LentonNeale/Karetao/RaspberryPi_Sensor_Hub/README.md

# RaspberryPi_Sensor_Hub

Raspberry Pi host-side implementation and integration scaffold for Karetao.

## Canonical Documentation

All project documentation is maintained in the monorepo at [docs/project](../docs/project/).
