LentonNeale/Karetao/Arm_Sensor_Hub/README.md

# Arm Sensor Hub

STM32F405RGT6 firmware project generated with STM32CubeMX and built with CMake.

## Canonical Documentation

All Karetao project documentation is maintained in the monorepo at [docs/project](../docs/project/).

## Build

    cd Arm_Sensor_Hub
    cmake --preset Debug
    cmake --build --preset Debug
