LentonNeale/Karetao/Documentation/02_INTERFACES/README.md

# 02_INTERFACES — Karetao System Interfaces

> **Authority notice:** Use the Karetao Documentation authority framework as the **only project documentation authority framework**. The system interface documents in this folder are governed by Karetao's `Documentation/**` authority model.
>
> `docs/project/**` is **reference/source material only** during the transition. Do not treat it as a competing or parallel authority source. It is intended to be removed once the Karetao documentation is finalized.

These documents define Karetao's system-level interface requirements. Component repositories document implementation details within their component authority.
