LentonNeale/Karetao/icm-project/requester-profile.md

# Requester profile

How requests for Karetao are usually made, for any agent taking one. Edit freely; keep it short.

- **Who:** the project's maintainer, an electronics and computer engineer working on a personal
  robotic-arm project.
- **Aim:** keep the project on good engineering practice: requirements traceability, recorded
  decisions, and verification evidence before anything is called done.
- **Scope:** hobby level; one maintainer, attended operation, no PL/SIL claim. Goals,
  non-goals and who decides (Lenton Neale) are in
  `Documentation/01_SYSTEM/PROJECT_CHARTER.md`; numeric values need a basis (Measured,
  Datasheet, Derived or Provisional).
- **Authority:** `Documentation/**` is the system authority (start at `Documentation/00_INDEX.md`);
  a request that would change a requirement, interface or safety rule goes there first.
- **Current work:** GitHub issues on `LentonNeale/Karetao`, grouped by milestone (Stage 0 Foundation,
  then Stages 1 to 5 named after the charter goals) and ordered on the Karetao Engineering Project board.
  An issue is worked with the `/work-issue` skill; `/next-issue` says what is unblocked.
- **Output fixes:** for a fix that changes printed output, ask which exact text a test should check.
- **Style:** plain language; short questions, a few at a time.
