LentonNeale/Karetao/docs/project/SYSTEM_DECISIONS.md

> **Transitional status:** This legacy decision register remains decision provenance. Current system requirement wording is maintained in [Documentation/01_SYSTEM/SYSTEM_REQUIREMENTS.md](../../Documentation/01_SYSTEM/SYSTEM_REQUIREMENTS.md), and current architecture decisions are maintained in [Documentation/07_DECISIONS/ARCHITECTURE_DECISIONS.md](../../Documentation/07_DECISIONS/ARCHITECTURE_DECISIONS.md). SD identifiers, status, rationale and open issues remain preserved here during reconciliation. System-owned normative statements are reconciled into the requirements authority; component-only constraints and unresolved proposals are not promoted automatically.

# Karetao System Decisions Register

This file lists the current SD-01 through SD-26 system decisions and the unresolved system-level issues that remain attached to them.

**Source for SD-01 through SD-25:** [CTO Final Decisions](archive/Arm_Sensor_Hub/Documentation/Conversations/CTO_DECISION_FINAL.md), dated 2026-09-07.

> The source document approves the v1.0 firmware contract baseline for implementation. It does **not** certify the assembled robot as safe or authorize energized motion; release remains conditional on the listed safety, validation, and acceptance conditions.

> **Note on the "Possible solutions to investigate" column:** these are candidate directions for closing each open issue, offered for engineering evaluation — not decisions, and not a substitute for the machine risk assessment or safety-rated analysis required before energized-motion release.

## Decision table

| ID | Decision area | Status | Summary | Open issue / comment | Detailed explanation | Possible solutions to investigate |
|---|---|---|---|---|---|---|
| SD-01 | System timing | MODIFIED | 100 Hz remains the baseline for sensor/state publication and the initial control loop. **The EKF update rate is currently set to 500 Hz** and will be adjusted if required by downstream system constraints. SPI remains at a 5 MHz initial maximum, subject to validation. | The current six-axis physical sweep is approximately 46 ms. The 500 Hz EKF rate therefore requires the estimator to operate from timestamped/latest-value data rather than implying a 500 Hz complete six-axis sweep. End-to-end EKF data availability and latency remain integration items. | A full six-axis sweep at ~46 ms corresponds to a complete-cycle rate of roughly 22 Hz, more than an order of magnitude below the 500 Hz EKF rate. This is only workable if the EKF is designed as an asynchronous filter that predicts forward using its motion model between sensor updates and corrects opportunistically as individual, timestamped axis readings arrive — not as a filter expecting a fresh full-state vector every 2 ms. This decision does not yet specify the prediction/correction scheduling, how per-axis update staleness is bounded, or how SPI/CAN latency adds to the effective age of each measurement by the time it reaches the filter. | Implement the EKF as an asynchronous/multi-rate filter (predict-at-500-Hz, correct-per-axis-as-available) rather than a synchronous full-vector filter; instrument and log actual per-axis update latency on target hardware to replace the 46 ms estimate with measured data; run a covariance/sensitivity analysis to find the EKF rate where added computation stops improving estimate quality, and consider whether a lower, still-useful rate (e.g. 100–250 Hz) removes the mismatch entirely; prototype an out-of-sequence-measurement (OOSM) handling scheme if late-arriving axis data is common. |
| SD-02 | System-wide failure classification | MODIFIED | Four response levels: INFORMATIONAL, DEGRADED, FAULT, SAFETY_CRITICAL; PL/SIL determined by machine risk assessment. | The classification must be mapped to explicit motion-inhibit behaviour and ownership. A fault classification alone does not define who has final authority to prevent motion. | Naming four severity tiers answers "how bad is this fault," not "what happens to motion because of it." Each level needs a defined, deterministic action (allow motion, degrade capability, inhibit new commands, force stop) and an owner component responsible for enforcing that action even if other software layers disagree or lag. Without this mapping, two subsystems could reach different conclusions about whether motion is currently permitted. This ties directly to the open "motion-permission authority" question (system issue #5) and to the safety-boundary question in SD-25. | Build an explicit state/action matrix (severity level × required motion behaviour × owning component) as a standalone design artifact reviewed alongside the machine risk assessment; designate a single motion-permission authority (see SD-25) that all other components must query or defer to, rather than allowing distributed veto logic; model the classification-to-action mapping as a formal state machine and verify it has no reachable state where two components disagree on permission. |
| SD-03 | Raspberry Pi communication loss | APPROVED | 500 ms heartbeat timeout; reject motion, controlled stop if possible, then motor disable; never hold the last motion command. | "Controlled stop" and "motor disable" require measurable fault-to-safe-state timing. The exact stop-time requirement remains a system/safety validation item. | The decision fixes *when* loss is detected (500 ms) and *what* sequence follows (reject → controlled stop → disable), but not *how long* the physical arm is allowed to keep moving after detection before it must be at a safe state. That number depends on joint dynamics, payload, and the hazard zone defined by the machine risk assessment, and it is what turns "stop safely" into a testable requirement (see release condition #2). | Derive a maximum stop-time budget from the machine risk assessment's hazard/reach-zone analysis, then work backward to a required deceleration profile per joint; measure actual worst-case stop time on the assembled arm at maximum commissioned speed/payload and compare against the budget; consider whether 500 ms is still appropriate once stop-time is known, or whether detection time needs to shrink to leave enough margin for the mechanical stop. |
| SD-04 | Motor feedback/command timeout | APPROVED | Five times the commissioned feedback period; one miss degraded; three consecutive misses inhibit the motor and escalate to FAULT. | This primarily addresses feedback/timeout behaviour. **Command acknowledgement must be distinguished from feedback freshness.** A command that is transmitted but not acknowledged requires an explicit failure rule before motion is considered safe. | This rule protects against a motor going quiet (no feedback), but a motor can also silently fail to *receive or accept* a new command — feedback can keep flowing (stale, from the last accepted state) while the controller never executed the latest instruction. Feedback freshness alone cannot detect that case. A separate acknowledgement contract (does the controller confirm receipt/acceptance of each command, within what window, and what happens on a missed ack) is needed and feeds directly into SD-13 (state fields) and SD-14 (command interface). | Confirm whether the target MKS controller firmware supports an explicit command-accepted response (per SD-05); if it does, define an ack-timeout mirroring the feedback-timeout pattern (N missed acks → degraded → inhibit); if it does not natively ack, investigate an indirect check — comparing commanded setpoint against the next feedback sample to infer acceptance — as a fallback, and flag the added latency/ambiguity this introduces. |
| SD-05 | CAN network requirements | MODIFIED | 1 Mbps nominal v1 target, standard 11-bit IDs, <50–60% measured average load target; exact hardware and timing require validation. | Exact MKS controller model, firmware, command semantics, feedback semantics, acknowledgement behaviour, brake behaviour, and CAN physical configuration remain open until target-hardware evidence is recorded. | The bus-level parameters (bitrate, ID width, load ceiling) are fixed as targets, but nearly everything above the bus layer — what a specific MKS controller model actually accepts as commands, how it reports feedback, whether it acknowledges commands distinctly from reporting state, and how it engages/releases any holding brake — is vendor- and firmware-specific and has not yet been confirmed against real hardware. This is a direct prerequisite for closing SD-04 (acknowledgement), SD-06 (bus failure scope), and release condition #3. | Obtain and review the exact MKS controller datasheet/CAN protocol manual for the specific model and firmware revision in use; run a hardware bring-up/bench test logging real CAN traffic under representative motion to capture actual message IDs, payload semantics, and timing; test brake engage/release behaviour in isolation before integrating; measure actual bus load under worst-case simultaneous multi-joint motion against the 50–60% target. |
| SD-06 | CAN bus failure | APPROVED | Detect bus-off, inhibit commands, perform bounded recovery, escalate after repeated failure, and require explicit reactivation. | Confirm whether a CAN failure affecting one motor requires a joint-level stop or whole-system stop. Final scope follows the machine risk assessment. | The recovery *procedure* is defined, but its *blast radius* is not: if one motor drops off the bus, is it safe to keep other joints moving, or does the kinematic coupling (including the differential end effector in SD-26) mean any single-joint fault must halt the whole arm? This is a risk-assessment question, not a protocol question, because the answer depends on what hazardous motion or configuration becomes possible if only some joints stop. | Build a coupling/hazard matrix showing, for each joint (including the SD-26 differential pair), what motion becomes possible or unsafe if that joint alone stops while others continue; feed this matrix into the machine risk assessment to decide per-joint vs whole-system stop scope; consider a tiered response (isolated joint stop only when the risk assessment shows the remaining joints cannot create a hazard, whole-system stop otherwise) rather than a single fixed rule. |
| SD-07 | Joint/motor mapping | APPROVED | Versioned deterministic logical-joint, sensor-ID, motor/CAN-ID mapping including direction, zero offset, and transmission ratio. | The ordinary one-to-one mapping is insufficient for the differential end effector. SD-26 defines the separate motor-to-end-effector-DOF mapping decision. | This decision establishes the pattern for simple joints (one motor, one sensor, one logical joint) but explicitly does not attempt to cover the end effector, where two motors jointly produce two rotational degrees of freedom through a differential mechanism. That case needs its own transformation, which is why it is carved out into SD-26 rather than forced into this table's schema. | No independent action needed on this decision itself; track as complete pending SD-26 closure. When SD-26 is finalized, review whether the mapping schema (SD-07) needs a generalized "coupled joint group" extension so future multi-motor mechanisms don't each require a bespoke carve-out decision. |
| SD-08 | Motor/joint temporal alignment | APPROVED | Observation skew below 5 ms normally, target below 1 ms for dynamic joints; retain acquisition timestamps. | The approximately 46 ms six-axis sweep must be reconciled with estimator/control requirements. Timestamp compensation does not by itself establish that the resulting state update rate is acceptable. | Skew (how far apart in time two joints' readings were taken) and update *rate* (how often a fresh reading arrives at all) are different problems. Tagging every reading with an accurate timestamp lets the EKF correct for skew mathematically, but it cannot manufacture data that hasn't arrived yet — if the full sweep takes 46 ms, some joints' state is necessarily up to 46 ms old regardless of how well-timestamped it is. Whether that staleness, even when compensated, is acceptable for control at the target dynamics is still unresolved. | Investigate parallelizing or reordering the six-axis sweep (e.g. simultaneous multi-sensor sampling instead of sequential) to reduce the 46 ms figure directly; separately, run a control-loop sensitivity study to determine the maximum tolerable staleness per joint at target speeds, so "acceptable" becomes a number rather than a judgment call; evaluate whether faster-changing joints could be sampled preferentially/more often than slower ones within the sweep budget. |
| SD-09 | Measurement history ownership | APPROVED | Raspberry Pi/EKF owns measurement queues and estimator history; STM32 provides bounded latest-value caches and coherent records. | The 500 Hz EKF setting requires explicit definition of how latest-value records, asynchronous sensor updates, timestamp age, and interpolation/hold behaviour are handled. | Deciding *who* owns history (Pi/EKF) answers the architecture question but not the algorithm question: when the EKF ticks at 500 Hz and a given joint's cached value is, say, 30 ms old, does the filter hold that value, extrapolate it forward using the motion model, discard it as too stale, or flag it as degraded? That policy needs to be specified per-signal and validated, since it directly determines estimator accuracy. | Define and document an explicit per-signal staleness policy (hold / model-based extrapolate / reject-as-invalid) with a maximum-age threshold for each; prototype both a simple hold-last-value approach and a motion-model extrapolation approach in simulation, and compare estimate error against ground truth to choose between them; expose the chosen policy's threshold as a tunable configuration so it can be adjusted once real sweep-timing data is available. |
| SD-10 | Calibration ownership | APPROVED | Calibration computed on Pi/workstation; STM32 receives validated parameters through a controlled configuration path. | Calibration must cover the differential mechanism as well as individual motor/sensor offsets and ratios. | The current scope covers per-axis calibration (zero offsets, direction, ratio for simple joints). The differential end effector needs calibration of the *coupling* itself — e.g. how the two motor positions jointly map to the two DOF zero points — which is a different, coupled calibration problem that must be defined once SD-26's transformation is finalized. | Once SD-26's forward/inverse transformation is defined, design a coupled calibration procedure (e.g. jointly zeroing both end-effector motors against known DOF reference positions rather than calibrating each motor independently); extend the calibration parameter set and validated-configuration path (SD-10/SD-11) to include the differential mechanism's specific parameters (coupling ratios, joint zero references). |
| SD-11 | Calibration storage | APPROVED | Versioned, CRC-protected redundant STM32 flash records with power-loss protection and host-side source copy. | Calibration flash schema, endurance, power-loss behaviour, and parameter integrity remain release conditions. | The storage *architecture* (versioned, CRC-checked, redundant, mirrored to host) is decided, but the concrete schema layout, flash wear/endurance under expected write frequency, and behaviour under a power loss mid-write have not yet been tested on hardware. This is explicitly listed as release condition #6 and must pass before energized-motion release. | Define the concrete flash schema (field layout, version header, CRC placement) and review it against the target MCU's flash datasheet for write-cycle endurance at expected calibration-update frequency; run repeated power-loss-during-write tests on the actual STM32 target to confirm redundant records recover correctly; add a boot-time integrity check that falls back to the host-side source copy if both on-device records fail validation. |
| SD-12 | Authoritative angle representation | MODIFIED | Calibrated radians are authoritative at host/API; wire-schema change must be explicitly versioned rather than silently replacing millidegrees. | Migration requires a defined schema version, conversion rules, Pi decoder update, and verification evidence before the existing wire field changes meaning. | Changing what a wire field *means* (millidegrees → radians) without a version bump would silently break any consumer still assuming the old units — a subtle and dangerous failure mode for a motion system. This decision requires a concrete migration package (new schema version number, explicit conversion formula, updated Pi-side decoding, and test evidence that old and new consumers cannot misinterpret each other) before the field is actually changed. It is release condition #5. | Assign a concrete new schema/protocol version number now, even before the switch date, so it can be referenced by implementation work; write the conversion function and unit-test it against known reference angles; add a runtime schema-version check on the Pi decoder that refuses to interpret a frame as radians unless the version field confirms it, preventing silent misinterpretation; stage the rollout so STM32 and Pi are updated together rather than allowing a mismatched pair to run. |
| SD-13 | Required joint state | APPROVED | Stable joint identity, position, velocity where available, validity/status, acquisition timestamp, sync quality, and calibration version. | Add explicit commanded-vs-actual state validity and command acknowledgement status where required by the final motor interface. | The current state message tells a consumer what the joint's *measured* condition is, but not whether the *last commanded* value was actually accepted and achieved. Adding commanded-vs-actual fields and an acknowledgement-status flag closes the gap identified in SD-04 and gives downstream control/safety logic a way to detect "command sent but not honoured" without inferring it indirectly from feedback timing. | Extend the joint-state message schema with a commanded-setpoint field, an actual-vs-commanded delta or validity flag, and an acknowledgement-status enum, once SD-04/SD-05 settle what acknowledgement data is actually available from the controller; version this schema change the same way SD-12 handles the angle-representation change, so it doesn't silently redefine existing consumers' expectations. |
| SD-14 | Required command interface | MODIFIED | Commissioned position/velocity plus enable, disable, and controlled-stop operations; heartbeat, lifecycle, calibration, and safety gating required. | Define command acknowledgement, freshness, timeout, cancellation, and the distinction between application controlled-stop and independent emergency stop. | Several distinct behaviours are still bundled informally under "stop": an application-level controlled stop (software-initiated, can be smooth/coordinated) is not the same mechanism as the independent emergency stop required by SD-25 (hardware-level, safety-rated, must work even if the application software has failed). The command interface needs each of these — ack, freshness/timeout, cancellation, and the two stop types — defined as separate, unambiguous operations so that safety logic never has to guess which "stop" a given signal represents. | Define "controlled stop" and "emergency stop" as two distinct, separately-named operations in the command interface spec, each with its own trigger path, and document explicitly that emergency stop must remain reachable through the independent safety path (SD-25) even if the application-level command interface is unresponsive; add explicit ack/freshness/timeout/cancel semantics to each commissioned command type, reusing the acknowledgement contract developed for SD-04; validate with a fault-injection test that emergency stop still functions when the normal command channel is deliberately blocked. |
| SD-15 | Fixed SPI transaction | APPROVED | 512-byte frame, 490-byte maximum payload, SPI Mode 0, little-endian fields, CRC-32/ISO-HDLC, deterministic request/response ownership. | Protocol sizing is defined, but the 5 MHz operating point remains an empirical integration limit until live Pi/STM32 and physical-layer evidence is accepted. | The frame format, size limits, and integrity check are all fixed and implementable now, but the 5 MHz clock is a *target*, not a proven operating point — it depends on real cabling, connector quality, and electrical noise on the assembled hardware. It must be validated (signal integrity, error rate, timing margin) on the actual Pi/STM32 link before being frozen, per release condition #4. | Run signal-integrity testing (oscilloscope eye-diagram / rise-time checks on the physical SPI lines) at 5 MHz on the actual wiring harness and connectors used in the assembled robot; measure CRC failure rate over an extended soak test at 5 MHz vs at a reduced clock (e.g. 1–2 MHz) to establish margin; if 5 MHz proves marginal, evaluate shielded/twisted-pair wiring, shorter runs, or a lower validated clock as fallbacks. |
| SD-16 | GET_SNAPSHOT priority | APPROVED | Correlated GET_SNAPSHOT response takes priority; active DMA buffers remain immutable; replacement frames use replace-if-new policy. | Confirm replacement/drop semantics preserve the freshest state required by the 500 Hz EKF and do not create unacceptable state age. | "Replace-if-new" avoids stale data overwriting fresh data, but at 500 Hz the margin for error is small: if snapshot requests are frequent or DMA buffer immutability causes brief stalls, some replacement frames could be dropped rather than merely delayed, silently increasing the effective age of what the EKF consumes. This needs to be checked under realistic request/traffic patterns, not just verified as logically correct. | Instrument the actual replace/drop path to log every dropped or delayed replacement frame during integration testing, then compute resulting worst-case data age per joint under realistic (not just nominal) GET_SNAPSHOT request rates; if dropped-frame age exceeds the staleness threshold from SD-09, consider prioritizing replacement over snapshot correlation in specific cases, or increasing buffer depth so a snapshot request doesn't force a drop. |
| SD-17 | SPI host transaction strategy | APPROVED | DATA_READY interrupt for latency plus configurable polling, initially 1 ms, for recovery; Pi remains SPI clock master. | Current Pi baseline does not have a physical DATA_READY GPIO assigned. Until one is assigned and tested, the 1 ms polling path is the available host notification mechanism. | The design assumes a low-latency interrupt line (DATA_READY) as the primary notification path, with 1 ms polling only as a fallback for recovery scenarios. Because no GPIO pin has actually been assigned for this signal yet, the system is currently running on the fallback path as its *only* path — meaning real transaction latency today is bounded by the 1 ms poll interval rather than interrupt-driven response, which is a meaningfully different (slower, jitterier) timing profile than the design intends and is relevant to the SD-01/SD-08 timing questions. | Assign an available Pi GPIO pin to DATA_READY as a concrete near-term task, then wire and test interrupt-driven notification on the bench; until that's done, measure actual achieved latency/jitter under the 1 ms polling-only path so its real impact on SD-01's timing budget is known rather than assumed; once the interrupt path exists, A/B test interrupt-driven vs polling-only timing to confirm the expected latency improvement. |
| SD-18 | Timestamp accuracy | APPROVED | Target timestamp error ≤ ±1 ms relative to shared STM32/Pi time model; expose sync validity and age. | Validate whether ±1 ms is sufficient for the 500 Hz EKF and downstream control requirements. | A 500 Hz EKF has a ~2 ms nominal update period, so a ±1 ms timestamp error is a large fraction of that period — potentially half a cycle of uncertainty on when a measurement was actually taken. Whether this is tolerable depends on how sensitive the estimator and controller are to timing error at the target dynamics; it has not yet been validated against the actual 500 Hz operating condition, only specified as a target. | Run a simulation or bench test injecting known timestamp errors up to ±1 ms into the EKF and measure resulting state-estimate error at the target 500 Hz rate and expected joint speeds; if error is unacceptable, investigate tightening the time-sync mechanism (see SD-19) or hardware timestamping closer to the sensor to reduce jitter, rather than relaxing the EKF rate. |
| SD-19 | TIME_SYNC frequency | APPROVED | 1 Hz nominal, configurable to 10 Hz; synchronization invalid after five seconds without an accepted update. | Validate synchronization stability and timestamp error under the 500 Hz estimator operating condition. | Sync frequency and the 5-second invalidation window were set independently of the 500 Hz EKF decision. It remains to be confirmed that clock drift between syncs stays within the ±1 ms budget (SD-18) for the full duration between updates, especially at the faster estimator rate where accumulated drift has more opportunities to matter before the next correction. | Measure the actual free-running clock drift rate of the STM32 oscillator between syncs on real hardware, and calculate whether drift stays under ±1 ms across a full 1 Hz sync interval (and worst-case up to the 5-second invalidation window); if drift exceeds budget, evaluate raising TIME_SYNC frequency to the already-supported 10 Hz configuration rather than changing the protocol. |
| SD-20 | Loss of time synchronization | MODIFIED | Continue acquisition/diagnostics but inhibit time-dependent motion until synchronization returns. | Define precisely which downstream operations are "time-dependent motion" and ensure the motion-permission layer enforces this consistently. | The rule correctly separates "keep gathering data" from "don't move," but "time-dependent motion" is not yet an enumerated, unambiguous category. Does it mean all motion (since the EKF that informs control is itself time-dependent), or only specific trajectory-timing-sensitive operations? Without a precise definition, different components could apply the rule inconsistently, undermining the intended safety effect. | Produce an explicit enumerated list of which operations count as "time-dependent motion" (likely: all closed-loop motion, since the EKF feeding the controller is itself time-dependent) and document it alongside SD-02's classification matrix; implement the check as a single shared gate in the motion-permission authority (see SD-02/SD-25) rather than letting each component independently interpret "time-dependent," and add an integration test that forces a sync loss and confirms motion is actually inhibited end-to-end. |
| SD-21 | Time offset validation | APPROVED | Wide initial offset range, then narrower runtime validation initially ±1 s; reject implausible updates without silent slew. | Verify that the initial and runtime bounds are appropriate for commissioning and reset behaviour. | The two-tier bound (loose at startup, tight at runtime) and the "reject rather than silently slew" rule are sound in principle, but the actual numeric bounds are provisional. They need to be checked against real commissioning scenarios (e.g. how far off can the clock plausibly be at first boot) and reset scenarios, to confirm they neither reject legitimate corrections nor accept implausible ones. | Survey realistic worst-case initial clock offset at cold boot (e.g. STM32 with no RTC vs one with battery-backed RTC) to confirm the wide initial range actually covers it; during commissioning and reset testing, log any legitimate TIME_SYNC updates that get rejected by the ±1 s runtime bound to check for false rejections; tune the bounds based on this evidence rather than leaving them at their initial provisional values. |
| SD-22 | Time behaviour after reset | APPROVED | Clear sync validity and volatile offset; timestamps remain unsynchronized until a new accepted TIME_SYNC. | Confirm that all consumers, especially the 500 Hz EKF, reject or correctly classify unsynchronized data after reset. | Clearing sync state on reset is only effective if every downstream consumer actually checks and respects the sync-validity flag before trusting a timestamp. The EKF is the most exposed consumer, given how timing-sensitive it is at 500 Hz — if it were to consume unsynchronized, arbitrarily-offset timestamps as if they were valid, it could produce a badly wrong state estimate immediately after a reset. This needs to be verified in the actual estimator implementation, not just assumed from the protocol design. | Add an explicit unit/integration test that forces a reset, then confirms the EKF (and every other timestamp consumer) either ignores incoming data or flags it degraded until a fresh TIME_SYNC is accepted; audit the EKF implementation specifically for any code path that could use a timestamp without first checking its validity flag; consider having the STM32 refuse to publish state data at all (rather than publishing with a validity flag) during the unsynchronized window, removing reliance on every consumer checking correctly. |
| SD-23 | Transient vs persistent fault recovery | APPROVED | Bounded service-specific retries; persistent/repeated/freshness failures enter ERROR and recover to INACTIVE. | Define system-level escalation when a subsystem is recovering but motion cannot be considered safe. Recovery must not race with motion permission. | Each service's retry/recovery logic is defined locally, but there is no stated rule for the *system-level* moment in between — while a subsystem is mid-recovery, is motion automatically inhibited, or could a different subsystem (unaware of the in-progress recovery) grant motion permission based on stale or partial information? This is a race-condition risk between per-service recovery state machines and the motion-permission logic referenced in SD-02. | Model recovery-in-progress as an explicit state visible to the motion-permission authority (SD-02), so permission logic can query "is anything currently recovering" rather than relying on each service to separately signal readiness; design and run a race-condition test that deliberately triggers a recovery and a motion request at the same time to confirm permission is correctly withheld until recovery fully completes; consider a system-wide "not ready" latch that only clears once all recovering services report healthy. |
| SD-24 | System restart and recovery | APPROVED | Return to INACTIVE; explicit dependency-ordered reactivation required; never automatically resume motor motion after recovery. | Establish the complete dependency order across STM32, Pi, ROS 2, EKF, ros2_control, MoveIt 2, and safety gating before physical motion release. | "Dependency-ordered reactivation" is the principle, but the actual ordered sequence — which subsystem must be confirmed healthy before the next is allowed to activate, across firmware, middleware, estimator, control, planning, and safety layers — has not yet been written down as a concrete startup/recovery sequence. This is needed before any physical motion release, since an incorrectly-ordered restart could bring motion capability online before, e.g., the safety system or EKF are actually ready. | Draft an explicit startup/recovery dependency graph naming each subsystem (STM32 firmware, Pi/ROS 2 bring-up, EKF initialization and sync acquisition, ros2_control, MoveIt 2, independent safety system) and the specific readiness condition each must satisfy before the next may proceed; implement this as a supervised, checked sequence (not just documentation) so activation cannot skip ahead if a dependency check fails; test the sequence under partial-failure scenarios (e.g. EKF slow to sync) to confirm it holds rather than proceeding anyway. |
| SD-25 | Independent safety mechanisms | MODIFIED | Independent E-stop, motor-disable/power-removal path, watchdog, stop/brake behaviour, fault indication, reset behaviour, and applicable safety-rated architecture are release gates. | The boundary and interface between Karetao application controls and the independent safety system must be explicitly defined by the machine risk assessment and safety architecture. | This decision commits to having an independent (i.e. not solely software-dependent) safety layer, but does not yet define exactly where the line sits between "the application software's controlled stop" and "the independent safety system's emergency stop" — what triggers each, whether they can interact, and what happens if the application layer disagrees with the safety layer. That boundary is properly a machine-risk-assessment and safety-architecture output, referenced as the unresolved dependency here and in SD-14. | Commission or complete the machine risk assessment as the primary input for this boundary, since it determines the required PL/SIL and therefore what must be independent of the application software; draft a safety architecture diagram explicitly showing which functions live in the independent safety path vs the application path, and where they physically/electrically interface (e.g. does the safety system have authority to cut power regardless of application state); validate with a fault-injection test that the independent path still functions with the application software deliberately disabled or hung. |
| SD-26 | Differential end-effector motor/DOF mapping | PROPOSED | The two end-effector motors drive two end-effector rotational DOFs through a differential mechanism. The mapping must be represented explicitly rather than as two independent one-to-one joints. | Define the forward/inverse transformation, motor signs, gear ratios, zero offsets, joint limits, singular/invalid configurations, and representation in ros2_control and MoveIt 2. This remains open until the mechanical model and mapping are verified. | Unlike the simple joints covered by SD-07, the two end-effector motors do not each correspond one-to-one with a single DOF; their combined positions determine both output DOFs through the differential mechanism. Closing this decision requires: the math (forward and inverse kinematics of the coupling), the physical parameters (motor sign conventions, gear ratios, zero references), the safety-relevant edges (joint limits and any singular or invalid motor-position combinations that would produce an undefined or unsafe output), and how all of that is represented as a proper model inside ros2_control and MoveIt 2 rather than being approximated as two independent joints. This is a prerequisite for SD-07's joint model being considered complete and is still PROPOSED, not approved. | Derive the differential mechanism's forward/inverse kinematic equations from its physical/CAD design and verify them against direct measurement on the assembled end effector; identify and document any singular or invalid motor-position combinations analytically, then add software-level limit checks that reject commands leading into them; implement the mapping as a custom ros2_control transmission (or MoveIt 2 joint group with a mimic/coupling constraint) rather than exposing the two motors as independent joints, and validate with hardware-in-the-loop testing across the full range of motion including near-limit and near-singular configurations. |

## Decision status

- **APPROVED:** 18
- **MODIFIED:** 7
- **PROPOSED:** 1
- **Total:** 26

## System-level issues still requiring closure

1. **EKF timing:** EKF is currently set to **500 Hz**; downstream constraints may require adjustment. This does not mean the complete six-axis sensor scan currently operates at 500 Hz.
2. **Sensor failure response:** The requirement that sensor-data failure stops motion needs an explicit rule covering invalid, missing, stale, and failed sensors.
3. **Motor command acknowledgement:** Command acknowledgement must be separately defined from motor feedback and communication heartbeat.
4. **Fault-to-safe-state timing:** "Stop immediately" must become a measurable timing requirement.
5. **Motion-permission authority:** Define which system component has final authority to permit or inhibit motion.
6. **Differential end effector:** The two-motor/two-DOF mechanical transformation must be formally defined before the joint model is frozen.
7. **Motor-controller semantics:** Exact MKS controller behaviour remains an integration dependency.
8. **Safety boundary:** Define the interface between application-level safety controls and the independent safety function.
9. **MoveIt 2 / ros2_control model:** The authoritative mechanical/joint model must include the differential end effector and its limits.
10. **Sensor update architecture:** Determine how a 500 Hz EKF consumes asynchronously updated sensor records and what maximum data age is acceptable.

These issues are intentionally recorded as open requirements rather than being assigned assumptions in this document.

## Important release conditions

The source approval identifies the following conditions before energized-motion release:

1. Complete and approve the machine risk assessment, including required safety functions and PL/SIL target.
2. Validate the independent E-stop and motor-disable path, measured stopping time, watchdog behaviour, and actuator brake/power behaviour on the assembled system.
3. Verify the exact MKS controller, CAN physical topology, APB1-derived bit timing, worst-case bus load, recovery behaviour, and termination before freezing CAN production configuration.
4. Validate the 5 MHz SPI limit, 1 ms polling fallback, GPIO notification, DMA timing, signal integrity, and host-stall recovery with the Raspberry Pi.
5. Version the radians representation before changing the current processed-millidegree wire field.
6. Complete calibration flash endurance, power-loss, schema, and parameter-integrity tests.
7. Treat failure of these conditions as a release blocker for energized motion.

## Authority and traceability

This register is a concise index of the current system decisions. The archived CTO decision document remains the detailed source for SD-01 through SD-25 rationale, value/policy, and approval conditions.

SD-26 is a project-level proposed decision added after review of the current Karetao system definition and is not part of the 2026-09-07 CTO approval.

If a decision is changed, update this register and the authoritative decision record together. Do not use this summary to override a newer approved system decision.
