LentonNeale/Karetao/Arm_Sensor_Hub/Documentation/CONTRACT_STATUS.md

# Contract Status Matrix

This matrix tracks project-level contracts across three independent dimensions:

- **Document status:** whether the contract document exists and is maintained.
- **Implementation status:** how much of the documented behavior exists in firmware.
- **Freeze status:** whether the contract is approved for implementation or still has integration gates.

| Contract | Owner | Boundary | Document status | Implementation status | Freeze status | Dependencies | Next action |
| --- | --- | --- | --- | --- | --- | --- | --- |
| [Contract v1.0 freeze](CONTRACT_V1_FREEZE.md) | System architecture | Cross-contract decisions | Exists | Reconciliation baseline | Approved baseline; integration/release gates remain | All contracts, Pi review | Complete named CAN, SPI, motor, and safety gates |
| [Lifecycle](LIFECYCLE_CONTRACT.md) | Application/system | App services and system sequencing | Exists | Configuration reaches INACTIVE after kernel initialization; one-shot dependency activation runs from default task context | Approved baseline | FreeRTOS task context, configuration/calibration/time/safety prerequisites | Implement prerequisite validation and explicit post-recovery activation request |
| [SPI host](SPI_CONTRACT.md) | System/Pi + STM32 | Raspberry Pi <-> SPI3 wire protocol | Exists | Fixed-frame validation, CRC, request/response priority, DATA_READY state, boot/status sequencing, and snapshot frame serialization are host-tested; DMA arm/complete/abort/re-arm loop executed on target hardware 2026-09-17 with no live SPI host attached; NSS behavior and signal integrity unmeasured | Approved baseline; maximum SPI clock gate remains | Payload schema, SPI service | Repeat the DMA run with a live Raspberry Pi host clocking real transactions, then validate the 5 MHz initial maximum with DMA, GPIO, and signal-integrity tests |
| [CAN service](CAN_SERVICE_CONTRACT.md) | CanService | App <-> CAN/MKS transport | Exists | Task-owned bounded priority TX queue, bounded retry policy, latest-value cache, and task-context bus-off stop/start path implemented; policy primitives host-tested and firmware build-covered, hardware behavior unvalidated | Approved baseline; CAN integration gate remains | Lifecycle, MKS codec, HAL CAN | Validate exact controller, transceiver/topology/termination, candidate timing, measured load, retry timing, and recovery behavior |
| [SPI payload](SPI_PAYLOAD_SCHEMA.md) | Application data model | Application records <-> SPI payload | Exists | Fixed offsets, snapshot sizing, and encoder output for sensor/motor caches are host-tested | Approved baseline | SPI host contract, timestamps | Extend coverage as more motor/sensor fields become live and retain target validation evidence |
| [Snapshot coherency](SNAPSHOT_COHERENCY_CONTRACT.md) | Sensor/CAN/SPI | Producers <-> SPI-owned snapshot | Exists | Two-buffer ownership, replacement diagnostics, and latest-cache snapshot serialization are host-tested | Approved baseline | Multi-sensor, SPI service | Expand producer coverage beyond the current commissioned sensor/motor set |
| [SPI service](SPI_SERVICE_CONTRACT.md) | SpiSlaveService | App payload <-> SPI3 DMA | Exists | Host-tested request/response, staged boot status, lifecycle-state NACKs, snapshot serialization, armed-then-assert DATA_READY, 1 ms poll recovery, and the SPI3 DMA arm/complete/error/stall process loop (stubbed HAL); firmware target compiles and, as of 2026-09-17, ran on a physical STM32F405 for ~23 s with the arm/stall/abort/re-arm cycle observed via debugger (234 cycles, zero drops, no live SPI host attached; DATA_READY pin level and NSS/DMA timing not independently measured) | Approved baseline; maximum SPI clock gate remains; DATA_READY wording revised to armed-then-assert 2026-09-17 | Payload, coherency, HAL DMA | Repeat the run with a live Raspberry Pi host and complete documented Pi/DMA/GPIO/signal-integrity clock acceptance testing |
| [I2C manager](I2C_MANAGER_CONTRACT.md) | I2CManager | App <-> I2C1 HAL | Exists | Public API/lifecycle exist; async completion and event delivery are deferred to task context; mux-plus-sensor composite write/read path is implemented for AS5600 access | Approved baseline | Lifecycle, mux | Expand composite-access coverage and define broader arbitration/recovery behavior |
| [Multi-sensor](MULTI_SENSOR_CONTRACT.md) | SensorTask/TCA9548A | Six AS5600 channels <-> sensor model | Exists | Six stable latest-value records; all six channels swept per 20 ms pass since 2026-09-15, ahead of the contract, with scan period, settle time, per-channel timeout, and healthy-channel threshold not frozen; host-tested on the communication-failure path; axis-to-mux-channel binding is configurable as of 2026-09-17 via `SensorTask_ConfigureMuxChannels()`, host-tested for validation and non-identity binding, with activation gated on a valid map; target run 2026-09-17 confirmed all six commissioned axes (SD2-SD7) reading valid magnet samples with zero communication or magnet errors, via `tools/check-sensors.sh`; an earlier SD2 wiring fault and magnet-placement issues were resolved on the bench; measured full six-axis sweep time (~46 ms) exceeds the 20 ms scan period the contract has not yet frozen | Approved baseline; scan parameters unfrozen | I2C, snapshot, mapping, calibration | Freeze scan period, per-channel timeout, and settle time in the contract against the measured ~46 ms sweep time |
| [Timestamp sync](TIMESTAMP_SYNC_CONTRACT.md) | System/SPI | STM32 monotonic time <-> Pi time | Exists | 64-bit TIM2 service, runtime sync state, and live SPI TIME_SYNC task-context acceptance are host-tested; target-hardware validation remains | Approved baseline | SPI transport, TIM2 | Validate end-to-end Pi-driven TIME_SYNC behavior on target hardware and retain build evidence |
| [Calibration records](CALIBRATION_CONTRACT.md) | Application configuration | Offline calibration -> validated STM32 parameters | Exists | Versioned record validation and generation selection host-tested; persistence absent | Approved baseline | Shared CRC helper, mapping, lifecycle | Define canonical CRC serialization and flash persistence/power-loss handling |
| [Joint mapping](JOINT_MAPPING_CONTRACT.md) | Application configuration | Logical joints -> AS5600 and CAN motor identities | Exists | Versioned one-to-one mapping validation host-tested; startup blocks dependent activation when invalid | Approved baseline | Calibration, SensorTask, future MotorService | Commission complete physical mapping and bind it to persisted configuration |
| [Error handling](ERROR_HANDLING_STRATEGY.md) | System | Service faults <-> lifecycle/health/host | Exists | Local statuses/counters exist | Approved baseline | Lifecycle, Health Monitor | Implement response-level events and bounded recovery escalation |
| [Health monitor](HEALTH_MONITOR_CONTRACT.md) | HealthMonitor | Service diagnostics -> system health | Exists | Read-only aggregate snapshot baseline implemented for lifecycle states, sync validity, and key counters; no host publication or fault-ack flow yet | Approved baseline | All services, error strategy | Expand snapshot thresholds, host reporting cadence, and fault acknowledgement behavior |
| [Build/configuration](BUILD_CONTRACT.md) | Buildsystem | Developer environment -> firmware | Exists | HostTests configure/build/test pass; Debug and Release compile and link with arm-none-eabi-gcc 13.2.1 on a developer machine; `arm-ci` now includes a firmware-build job whose first run result is not yet recorded; on 2026-09-17 the Debug build was flashed to a physical STM32F405 via ST-LINK/V2.1 and booted, with all four services (I2C, CAN, SPI, Sensor) reaching `LIFECYCLE_STATE_ACTIVE` with zero activation failures over a ~23 s debugger-sampled run | Approved baseline | CMake, CubeMX, toolchain | Record the first CI firmware-build result; retain size/checksum artifacts and this boot run as target-build evidence |
| [Motor service](MOTOR_SERVICE_CONTRACT.md) | Future MotorService | Joint API -> CanService | Exists | No separate MotorService exists | Integration gate: exact controller behavior and commissioned commands | Define only when needed | Verify exact controller behavior before freezing command semantics |

## Review Rules

- A contract must not claim an implementation exists when the corresponding service is still a scaffold.
- Remaining gates must be explicitly marked: CAN bitrate and physical/retry/TX policy; maximum SPI clock acceptance; exact motor-controller behavior; and independent safety validation/machine risk assessment. The 1 Mbps CAN target and 5 MHz initial SPI maximum are configuration baselines, not approvals for production use. Approved v1.0 values must not be described as open.
- Implementation changes that alter a contract require updating the contract and this matrix in the same change.
