LentonNeale/Karetao/Arm_Sensor_Hub/Documentation/SPI_SERVICE_CONTRACT.md

# Deprecated local copy

The canonical monorepo SPI service contract now lives at [`/docs/interfaces/spi-service-contract.md`](../../docs/interfaces/spi-service-contract.md).

Keep this stub so older local links continue to resolve from the ARM subtree.
