LentonNeale/Karetao/icm-project/workspaces/portal-retirement-2026-10-15/body-B62.md

Origin: backlog story B62 (WP9, "S9.11 Pi packaging and small defects: pyproject, shared ACK parser and sequencer, resource cleanup, stable spidev path, adapter tests")

## Context

The Pi package has no `pyproject`, the ACK parser and sequencer are duplicated, resources are not released on error, the spidev device path is not stable across bus renumbering, and the adapters lack tests (findings HOST-21 to HOST-25).

## Scope

Packaging and small defects in `RaspberryPi_Sensor_Hub/src/spi` and `tools`. The shared sequencer is the process-wide Sequencer built by the Pi exchange-session issue; this issue points at it and does not build a second one.

## Acceptance Criteria

- [ ] A `pyproject` makes the Pi package installable and the tests runnable from it
- [ ] There is one ACK parser and one sequencer, shared by the library and the tools
- [ ] SPI and GPIO resources are released on error paths, covered by tests
- [ ] The spidev path is stable across bus renumbering (see the linux-spidev bus-number note)
- [ ] The SPI adapters have unit tests
- [ ] Each finding is resolved as its report proposes, or a ruling by Lenton Neale records why not
- [ ] HostTests, the Debug build and the Pi tests pass; `doc_check` is clean
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
