LentonNeale/Karetao/Documentation/03_COMPONENTS/README.md

# 03_COMPONENTS — Karetao System Component Definitions

> **Authority notice:** Use the Karetao Documentation authority framework as the **only project documentation authority framework**. Karetao owns the system-level definition of components; component repositories own implementation documentation within their scope.
>
> `docs/project/**` is **reference/source material only** during the transition. It is not current authority and is intended to be removed once the Karetao documentation is finalized.

Do not infer authority from directory location alone. Use `DOCUMENTATION_AUTHORITY_MODEL.md` and `COMPONENT_DOCUMENTATION_MODEL.md` for the applicable authority boundary.
