LentonNeale/Karetao/workspace/setup/templates/icm-project/github.md

# Tracker conventions

Identifiers are in `github.env`. The rules below are pointers to the project's own contract where one exists.

## Titles

## Labels (approved)

## Board fields

| Field | Options |
|---|---|

## Milestones

## Register (optional)

<!-- Path, and which columns issue-clerk may change. -->

## Branching / push policy
