LentonNeale/Karetao/workspace/setup/templates/icm-project/requester-profile.md

# Requester profile

Read by `client-liaison` at the start of every conversation. It records how this project's requester usually phrases requests: what they reliably provide, what they often leave out or keep vague, and what their shorthand means. It is built from evidence (for example `workspace/tests/liaison/extract_prompts.py` plus an analysis) and updated as habits change.

## Reliably provided (don't re-ask)

## Often missing: ask proactively

| Gap | When it shows up | Question to ask |
|---|---|---|

## Often vague: ask for the concrete form

| Vague form | Ask for |
|---|---|

## Unstated expectations: confirm up front

| Expectation | Question to ask |
|---|---|

## Phrasing guide

| Phrase or spelling | Means |
|---|---|
