LentonNeale/Karetao/workspace/setup/templates/icm-project/build.md

# Build and test commands

| Component | Directory | Command | Notes |
|---|---|---|---|
