LentonNeale/Karetao/workspace/setup/templates/icm-project/PROJECT.md

# Project

<!-- One paragraph: what the project is. -->

## Components

| Path | What it is | Notes |
|---|---|---|

## Shared interfaces (keep in lockstep)

| Interface | Implementations | Contract |
|---|---|---|
