LentonNeale/Karetao/icm-project/workspaces/implement-step.overlay/stages/02-change/CONTEXT.md

## Inputs

| References | `../../shared/references.md` | Only the rows for the code areas this step touches, then only the note and section each row names | Datasheet, protocol and API facts the change must match; never values from memory |
