LentonNeale/Karetao/Documentation/05_VERIFICATION/README.md

# 05_VERIFICATION — Karetao System Verification

> **Authority notice:** Use the Karetao Documentation authority framework as the **only project documentation authority framework** for Karetao system documentation and governance.
>
> `docs/project/**` is **reference/source material only** during the transition. It may be consulted for provenance and evidence review, but it is not current authority and is intended to be removed once the Karetao documentation is finalized.

`SYSTEM_VERIFICATION_MATRIX.md` is the authoritative location for Karetao system-level verification status. Component evidence does not by itself establish system verification.
