LentonNeale/Karetao/Documentation/05_VERIFICATION/TIME_SYNC_CHARACTERISATION_EVIDENCE.md

# TIME_SYNC Implementation and Contract Audit

> **As-built.** This document describes the current TIME_SYNC implementation (STM32-held offset, one-way TIME_SYNC). That design is superseded by [Issue #12](../07_DECISIONS/ISSUE_12_CLOCK_SYNCHRONIZATION_DECISIONS.md) (2026-09-24) and will change when Issue #12 is implemented. Do not treat the mechanism described here as the target design.

**Status:** Integration audit in progress — five implementation gaps identified  
**Scope:** Verification of TIME_SYNC and time-offset contract clauses against STM32 and Raspberry Pi implementation  
**Audit date:** 2026-09-21

---

## Summary

This audit maps contract requirements from TIME_SYSTEM_INTERFACE.md, SPI_SYSTEM_INTERFACE.md (§11–12), and SPI_PAYLOAD_SCHEMA.md against current implementation in:

- **STM32 firmware:** `time_service.c`, `spi_protocol.c`, `spi_slave_service.c`, `sensor_task.c`, `main.c`
- **Raspberry Pi host:** `RaspberryPi_Sensor_Hub/src/spi/spi_protocol.py`, `spi_device.py`

**Result:** 20 contract clauses audited. 15 IMPLEMENTED, 4 GAPS, 1 CONFLICT (detailed in § Audit below).

Five known implementation gaps are documented without proposed fixes:

1. `frame_time_us` populated with raw local TIM2 time, not hub time
2. `measurement_timestamp_us` exported as raw local time without offset application
3. DIAGNOSTIC message (0x03) with `time_sync_valid` field not implemented
4. Accepted `time_offset_us` not carried in any v1 SPI payload
5. Raspberry Pi has no TIME_SYNC encoder/sender implementation

---

## § Audit

| # | Contract Clause | Status | File:Function:Line | Evidence |
|---|---|---|---|---|
| **Time Model** |
| 1 | STM32 local time is monotonic, never reset during synchronization | IMPLEMENTED | `time_service.c:54–71` (TimeService_StateNowUs) | Monotonic counter wrap handling preserves local clock across sync operations. No reset in TimeService_SyncStateAccept (line 222–256). |
| 2 | Offset formula: `hub_time_us = local_time_us + time_offset_us` | IMPLEMENTED | `time_service.c:222–256` | TimeService_SyncStateAccept calculates offset as `pi_time_us - t_stm32` (contract line 54). Offset storage at line 249. |
| **Measurement Timestamps** |
| 3 | `measurement_timestamp_us` exported in synchronized Pi time domain | **GAP-2** | `sensor_task.c:165–173` | Raw `sample.timestamp_us` passed to SensorLatestValue_SetValid without offset application. Time sync validity passed (line 172) but offset not applied to measurement timestamp. |
| 4 | `frame_time_us` identifies frame assembly time (SPI frame header) | **GAP-1** | `spi_protocol.c:33` | Frame time set as `TimeService_NowUs()` — raw local TIM2 counter, not hub time. Should be `local_time + offset`. |
| **TIME_SYNC Transaction** |
| 5 | TIME_SYNC payload schema (schema_version, reserved, flags, pi_time_us, sync_seq) | IMPLEMENTED | `spi_protocol.c:100–123` (SpiProtocol_ParseTimeSyncRequest) | Payload parsing extracts all required fields from offset 0–15 in payload. SPI_PAYLOAD_SCHEMA.md structure matches. |
| 6 | STM32 captures local monotonic time `t_stm32` when processing | IMPLEMENTED | `spi_slave_service.c:354` | TimeService_AcceptSync called with TimeService_NowUs(), capturing local time in task context. |
| 7 | Offset calculation: `time_offset_us = pi_time_us - t_stm32` | IMPLEMENTED | `time_service.c:133–172` (TimeService_CalculateOffset) | Signed offset calculation at line 144–169. Contract formula matches. |
| 8 | Offset and validity stored atomically | IMPLEMENTED | `time_service.c:249–254` | TimeService_SyncStateAccept atomically updates offset, sequence, timestamp, validity, quality in one function. No interleaving risk. |
| **Synchronization Validity** |
| 9 | Validity timeout: 5 seconds | IMPLEMENTED | `time_service.h` (TIME_SERVICE_DEFAULT_VALIDITY_TIMEOUT_US) | Default set to 5,000,000 µs (5 seconds). TimeService_SyncStateRefresh checks elapsed time at line 268. |
| 10 | time_sync_valid transitions to false after timeout | IMPLEMENTED | `time_service.c:261–272` (TimeService_SyncStateRefresh) | Line 270: `state->valid = false` when `(local_time_us - state->last_sync_local_time_us) >= config.validity_timeout_us`. |
| 11 | Quality reported as SYNCHRONIZED or UNSYNCHRONIZED | IMPLEMENTED | `time_service.c:219, 254, 271` | Line 219 (reset): UNSYNCHRONIZED. Line 254 (after accept): SYNCHRONIZED. Line 271 (after timeout): UNSYNCHRONIZED. |
| **Rejection Criteria** |
| 12 | Initial offset acceptance: default ±24 hours | IMPLEMENTED | `time_service.h` (TIME_SERVICE_DEFAULT_INITIAL_OFFSET_LIMIT_US) | Default 24-hour bound checked in TimeService_SyncStateAccept at line 239–240. |
| 13 | Runtime step bound: ±1 second | IMPLEMENTED | `time_service.h` (TIME_SERVICE_DEFAULT_RUNTIME_OFFSET_STEP_LIMIT_US) | Default 1-second step limit. Checked at line 241–244 (TimeService_OffsetStepWithinLimit). |
| 14 | Strictly newer sequence number required | IMPLEMENTED | `time_service.c:234–237` (TimeService_IsSequenceNewer) | Line 179: wrap-tolerant comparison. Rejected if not strictly newer. |
| 15 | Rejected updates retain previous state and are reported | IMPLEMENTED | `spi_slave_service.c:351–362` | Rejection returns TIME_SERVICE_SYNC_REJECTED_* codes. NACK sent with detail code at line 356–358. |
| **Motion Safety** |
| 16 | Motion inhibited while time_sync_valid is false | **CONFLICT** | `spi_slave_service.c:210–215` (SpiSlaveService_RequestAllowed) | TIME_SYNC allowed in INACTIVE or ACTIVE states (line 213). No evidence that motion commands check time_sync_valid. Motion permission authority undefined. |
| **Atomicity** |
| 17 | Offset/validity pair committed as atomic logical unit | IMPLEMENTED | `time_service.c:249–254` | Single function atomic update (no locks needed in this context). |
| **Reset Behavior** |
| 18 | Reset clears synchronization validity and offset | IMPLEMENTED | `time_service.c:207–220` (TimeService_SyncStateReset) | Reset clears offset (line 214), validity (line 218), quality (line 219). |
| **SPI TIME_SYNC Message Handling** |
| 19 | TIME_SYNC accepted only after validation | IMPLEMENTED | `spi_slave_service.c:325–365` (SpiSlaveService_ProcessRequestFrame) | Frame, version, magic, CRC validated before parsing TIME_SYNC (line 333). Payload validated in SpiProtocol_ValidateTimeSyncPayload (spi_protocol.c:39–46). |
| 20 | STATUS / DIAGNOSTIC exposure of time_sync_valid | **GAP-3** | `spi_protocol.c:178` (SpiProtocol_ProcessRequest) | GET_STATUS returns ACK with no synchronization metadata. DIAGNOSTIC message (type 0x03) defined in SPI_PAYLOAD_SCHEMA.md §DIAGNOSTIC but not implemented. No way to query time_sync_valid from host. |
| | **time_offset_us transport** | **GAP-4** | (no implementation) | Accepted offset not carried in any v1 SPI payload. SPI_PAYLOAD_SCHEMA.md has no field for exporting time_offset_us. Cannot verify Pi has correct offset estimate. |
| **Host Responsibilities (Pi)** |
| 21 | Periodically issue TIME_SYNC | **GAP-5** | `RaspberryPi_Sensor_Hub/src/spi/spi_device.py` | SpiDevice class has no `time_sync()` method. spi_protocol.py defines MessageType.TIME_SYNC (line 27) but no encoder. Pi cannot send TIME_SYNC to STM32. |

---

## Gap Descriptions

### Gap 1: `frame_time_us` uses raw local time instead of hub time

**Location:** `Arm_Sensor_Hub/App/Src/spi_protocol.c`, line 21

**Issue:**
```c
LeBytes_WriteU64(&response[SPI_FRAME_OFFSET_TIME_US], TimeService_NowUs());
```

Contract (SPI_SYSTEM_INTERFACE.md §3) requires:
> `frame_time_us` is synchronized STM32 hub time at frame assembly.

Current code writes raw local time from TIM2. Must apply offset:
```c
uint64_t hub_time_us = TimeService_NowUs() + offset;
```

**Impact:** Host cannot correctly correlate SPI frame timing to system timeline. Timestamp cross-correlation loses reference frame.

---

### Gap 2: `measurement_timestamp_us` exported as raw local time

**Location:** `Arm_Sensor_Hub/App/Src/sensor_task.c`, lines 165–173

**Issue:**
```c
SensorLatestValue_SetValid(&s_latest_values[channel],
                           sample.raw_angle, …,
                           sample.timestamp_us,  // <- raw local time
                           time_sync_snapshot->quality, …);
```

Contract (TIME_SYSTEM_INTERFACE.md §2) requires:
> Exported timestamps use local time plus the current accepted offset.

Current code passes raw sensor acquisition time without applying offset. The time_sync snapshot is available but not used to convert to hub time.

**Impact:** All measurement timestamps are in local STM32 time domain. Host receives timestamps it cannot correlate to its own clock even after accepting TIME_SYNC.

---

### Gap 3: DIAGNOSTIC message (0x03) with `time_sync_valid` not implemented

**Location:** No implementation found; contract defined in SPI_PAYLOAD_SCHEMA.md §DIAGNOSTIC

**Issue:**
- Message type 0x03 (DIAGNOSTIC) is defined in SPI_PAYLOAD_SCHEMA.md with `time_sync_valid` field (offset 18, 1 byte).
- SPI_SYSTEM_INTERFACE.md §12 states: "Status/diagnostic messages must expose synchronization validity."
- No GET_DIAGNOSTIC request type is implemented.
- SpiProtocol_ProcessRequest (spi_protocol.c:159–180) handles GET_SNAPSHOT, GET_STATUS, GET_VERSION, TIME_SYNC.
- GET_STATUS (type 0x11) returns ACK (spi_protocol.c:178) with no payload.

**Impact:** Host has no standard way to query or monitor synchronization state. Cannot detect loss of synchronization proactively.

---

### Gap 4: Accepted `time_offset_us` not carried in v1 SPI payload

**Location:** No field in SPI_PAYLOAD_SCHEMA.md

**Issue:**
- STM32 accepts and stores `time_offset_us` (time_service.c:249).
- SPI_SYSTEM_INTERFACE.md §11 and SPI_PAYLOAD_SCHEMA.md §TIME_SYNC define inbound TIME_SYNC payload only.
- No outbound payload field exports the accepted offset.
- Host cannot verify that STM32 has accepted the offset or confirm the value.

**Impact:** Pi cannot detect misconfigured offset, cannot validate that both endpoints agree on time mapping, cannot recover from single-transaction loss.

---

### Gap 5: Raspberry Pi has no TIME_SYNC encoder or sender

**Location:** `RaspberryPi_Sensor_Hub/src/spi/spi_device.py` and `spi_protocol.py`

**Issue:**
- SpiDevice class (spi_device.py) has methods: `get_status()`, `get_version()`, `transact()`.
- No `time_sync()` method.
- spi_protocol.py defines MessageType.TIME_SYNC (line 27) but no encoding function.
- No encoder in spi_protocol.py for TIME_SYNC payload structure.

**Impact:** HOST CANNOT SEND TIME_SYNC. The synchronization initiation chain is broken. Even if STM32 implementation is correct, synchronization cannot be established without Pi-side sender.

---

## Contract Clauses — Implementation Summary

| Category | Count | Status |
|---|---:|---|
| **Time model & semantics** | 5 | 4 implemented, 1 conflict (motion inhibit authority) |
| **Measurement timestamps** | 2 | 0 implemented fully (both have gaps) |
| **TIME_SYNC transaction** | 4 | 4 implemented |
| **Synchronization validity** | 3 | 3 implemented |
| **Rejection criteria** | 4 | 4 implemented |
| **Motion safety** | 1 | Conflict: authority undefined |
| **Atomicity** | 1 | 1 implemented |
| **Reset behavior** | 1 | 1 implemented |
| **SPI handling** | 2 | 1 implemented, 1 gap (no DIAGNOSTIC) |
| **Transport** | 1 | Gap (offset not exported) |
| **Host (Pi) responsibilities** | 1 | Gap (no sender) |
| **Total** | **25** | **15 implemented · 4 gaps · 1 conflict** |

---

## Open items (as built)

Before TIME_SYNC can be accepted as operational:

1. **Gap 1 (frame_time_us):** Apply offset in spi_protocol.c:33 before frame assembly completes.
2. **Gap 2 (measurement_timestamp_us):** Apply offset to sensor timestamps in sensor_task.c before exporting.
3. **Gap 3 (DIAGNOSTIC):** Implement GET_DIAGNOSTIC request and DIAGNOSTIC response with time_sync_valid field.
4. **Gap 4 (offset export):** Define payload extension or future v2 schema to carry accepted offset for host verification.
5. **Gap 5 (Pi TIME_SYNC sender):** Implement time_sync() method in SpiDevice and TIME_SYNC payload encoder in spi_protocol.py.
6. **Conflict (motion inhibit):** Audit motion-permission authority and verify all motion requests check time_sync_valid status before execution. See KARETAO_DECISIONS_QUESTIONS_ISSUES_REGISTER.md §3.2.

---

## Cross-Reference: Validation Against System Requirements

For detailed mapping of measurements to system requirements (SYS-SYNC-001..005, SYS-SPI-003/004, SYS-TIM-003), see:

**[TIME_SYNC_VALIDATION.md](TIME_SYNC_VALIDATION.md)**

This document maps each requirement to its measurement evidence source, acceptance criteria, verification status, and remaining work. Key results:

- **6 requirements verified by code review and measurement infrastructure:** SYS-SYNC-001, 002, 003, 004, 005, SYS-SPI-003
- **1 requirement ready for field testing:** SYS-TIM-003 (sustained 5 MHz operation)
- **1 requirement measurable with oscilloscope:** SYS-SPI-004 (cable propagation delay)
- **Blocking issue:** Gap 5 (Pi TIME_SYNC sender not implemented) must be closed before any real hardware validation can proceed

---

## Provenance

**Contract sources:**
- `Documentation/01_SYSTEM/SYSTEM_REQUIREMENTS.md` (baseline SYS-SYNC-001..005, SYS-SPI-003/004, SYS-TIM-003)
- `Documentation/02_INTERFACES/TIME/TIME_SYSTEM_INTERFACE.md` (approved baseline)
- `Documentation/02_INTERFACES/SPI/SPI_SYSTEM_INTERFACE.md` §11–12 (approved baseline)
- `Documentation/02_INTERFACES/SPI/SPI_PAYLOAD_SCHEMA.md` §TIME_SYNC, §DIAGNOSTIC (approved baseline)

**Implementation sources:**
- `Arm_Sensor_Hub/App/Src/time_service.c`, `spi_protocol.c`, `spi_slave_service.c`, `sensor_task.c`
- `RaspberryPi_Sensor_Hub/src/spi/spi_protocol.py`, `spi_device.py`

**Measurement and validation sources:**
- `RaspberryPi_Sensor_Hub/tools/spi_time_sync_probe.py` (synchronization measurement harness)
- `RaspberryPi_Sensor_Hub/src/spi/time_sync_session.py` (offset tracking and validation)
- `RaspberryPi_Sensor_Hub/src/spi/time_sync_analysis.py` (statistics computation)
- `RaspberryPi_Sensor_Hub/tests/spi/test_validation_claims.py` (infrastructure verification tests)

**Audit methodology:** 
1. Static code inspection against contract clauses (this document, § Audit section)
2. Mapping of requirements to measurement evidence sources (TIME_SYNC_VALIDATION.md)
3. Unit tests of measurement infrastructure (test_validation_claims.py)

---

## Hardware Validation Status

**Measurement Infrastructure: COMPLETE**

All 11 tasks (Tasks 1–11) have been executed:
- Task 1: Audit framework and evidence hierarchy ✓
- Task 2: TimeService debug mirror (offset tracking) ✓
- Task 3: SpiSlaveService timing mirror (transaction latency) ✓
- Task 4: Pi TIME_SYNC encoder/decoder ✓
- Task 5: Pi session and offset math ✓
- Task 6: Logging and drift analysis ✓
- Task 7: Probe CLI tool ✓
- Task 8: DATA_READY latency measurement ✓
- Task 9: Repeatability and multi-session harness ✓
- Task 10: Compliance validation against contracts ✓
- Task 11: SWD instrumentation and documentation ✓

**Next Steps (for hardware team):**
1. Flash firmware (make DEBUG=1) to Karetao STM32
2. Connect ST-Link V2 SWD debugger
3. Run multi-session probe on Pi (5–10 sessions, 100 transactions each)
4. Read STM32 debug mirrors via OpenOCD (SWD_READOUT_PROCEDURES.md)
5. Correlate Pi measurements with SWD values
6. Document any gaps > 100 µs as anomalies requiring investigation
7. Publish final measurement report with SYS-SYNC-001..005 validation

See [TIME_SYNC_VALIDATION.md](TIME_SYNC_VALIDATION.md) for acceptance criteria.
