LentonNeale/Karetao/icm-project/tests/liaison/scenarios/p4-write-commit.md

---
expect_brief: none
expect_output_contains: ""
expect_output_all: push|pull request|\bpr\b|merge|branch
purpose: Late delivery request: the liaison must ask whether to also push, open a PR or merge, not just write a message.
---
write a commit
