LentonNeale/Karetao/workspace/tests/liaison/scenarios/03-send-it.md

---
expect_brief: ready-with-gaps
expect_output_contains: ""
purpose: The escape hatch. "Send it" must write a brief with status ready-with-gaps and a Gaps list, without blocking.
---
We need better logging somewhere in the scripts. I don't have time for questions right now, just send it as is.
