LentonNeale/Karetao/icm-project/workspaces/issue-alignment-2026-10-15/body-61.md

> *This was generated by AI during triage.*
> Triage state: ready-for-agent (the brief is work package WP11 and its stories)

## Context
Charter goal 2: the snapshot carries the shaft position of every commissioned MKS motor, at rest and in motion. Register item **LIVE-18 Six motor positions in the snapshot** (`Documentation/07_DECISIONS/KARETAO_DECISIONS_QUESTIONS_ISSUES_REGISTER.md` §0), which absorbed #22, #29 and #51. The 2026-10-14 code review found the CAN path polls a single motor, mixes position with speed and acks in one record, and has no bus-off recovery path; the fixes are planned as work package **WP11 Stage 2 code: six motor positions over CAN** in `icm-project/lifecycle.json`.

## Scope
Stories B79 to B90 and B131 in `icm-project/backlog.json`:
- CAN bit timing at 1 Mbit/s (PRM-CAN-03 applied, ruling R9a); each drive's CAN ID, model, firmware, work mode, response mode, FFH and 85H settings read as found on the bench (`Hardware/bench-wiring/JOINT_SHEET.md`), then set per the decisions "MKS drive work mode" and "MKS drive settings" (`BRING_UP.md` phase 6) and recorded in `SYSTEM_CONFIGURATION.md` §2.2 (B79, rulings R9b, R25a). The firmware checks these settings at CAN activation and withholds `motor_ready` on a mismatch; a Pi-side commissioning tool sets them in phase 6 (decision "MKS drive settings", "Who sets and who checks", 2026-10-15).
- Six motors registered from one validated, versioned table; duplicate and broadcast IDs rejected (B80, SYS-ENC-003, SYS-MAP-001).
- CAN polling and draining independent of the sensor sweep; every registered motor polled each cycle (B81, ruling R15).
- RX interrupt with reception-time capture (B82, SYS-TS-001); motor record keeps position separate from speed and acks (B83, ruling R10a).
- Feedback timeout and miss escalation per PRM-MOT-01/02 (B84, SYS-MOT-002).
- Bus-off detected from hardware, lifecycle leaves ACTIVE, recovery judged by ESR, queue purged, no automatic retry after ERROR (B85, ruling R12).
- Pi decodes motor records (31H signed int48) with validity bits per ruling R10b; DIAGNOSTIC v1 and GET_DIAGNOSTIC 0x15 (B88, B89, ruling R14).
- Drive protocol module `drive_protocol.[ch]`: frame-in feedback-out, per-drive state, poll deadlines, motor ready; `can_service` becomes transport only (B131).

Out of scope: motor commands and the motion gate (LIVE-20), clock-sync conversion on the Pi (LIVE-19, #42), bench evidence (the companion verification issue).

## Acceptance Criteria
- [ ] WP11 acceptance lines met as written in `icm-project/lifecycle.json`.
- [ ] `SYS-MOT-001` and `SYS-MOT-002` implemented per `SYSTEM_REQUIREMENTS.md`; C and Python motor-record layouts in lockstep with `SPI_PAYLOAD_SCHEMA.md`.
- [ ] Stage 2 host tests pass; `MOTOR_BENCH_PROCEDURE.md` written (B90).
- [ ] HostTests, Debug build and Pi tests pass; `doc_check` clean; task stack check passes.

## Verification / Evidence
Host tests and the Debug build are the definition of done for the code. Bench evidence is the companion issue `[LIVE-18] Verify motor positions on the bench at rest and in motion`.

## References
- `SYSTEM_REQUIREMENTS.md` SYS-MOT-001, SYS-MOT-002; `CAN_SYSTEM_INTERFACE.md`; `SPI_PAYLOAD_SCHEMA.md` motor record
- `ARCHITECTURE_DECISIONS.md` rulings R9 to R15 and the decisions "MKS drive work mode", "MKS drive settings" and "MKS motion commands" (31H position feedback, F7H fallback stop); `SYSTEM_CONFIGURATION.md` §2.2; MKS manual in `icm-project/references/mks-servo42d-57d-can/`
- Superseded issues: #22, #29, #51
