LentonNeale/Karetao/icm-project/workspaces/issue-alignment-2026-10-15/body-62.md

> *This was generated by AI during triage.*
> Triage state: ready-for-human (bench work on target hardware)

## Context
Register item **LIVE-18** requires bench evidence that every registered motor's position appears in the snapshot, at rest and during motion, and that an interrupted motor's record goes stale on time. This is the Stage 2 part of work package **WP16 Bench bring-up and verification** in `icm-project/lifecycle.json`.

## Scope
- Run `MOTOR_BENCH_PROCEDURE.md` (written under B90) with all six motors powered: every motor record valid and its position changing when the joint is turned by hand (ruling R28(c): Stage 2 shows positions at rest and turned by hand). The "follows commanded motion" part of the SYS-MOT-001 acceptance is evidenced at Stage 4, in #65.
- With one motor unpowered: only that record goes stale (SYS-MOT-001 acceptance).
- Feedback interrupted on one motor: record stale within PRM-MOT-01, escalation per PRM-MOT-02 visible in diagnostics (SYS-MOT-002 acceptance).
- Each record carries its STM32 acquisition timestamp, converted on the Pi (SYS-TS-001; needs #42 or an interim as-built note).
- Motion source for Stage 2 per ruling R28(c).

Prerequisites: the implementation issue `[LIVE-18] Implement six motor positions in the snapshot over CAN` done; bench wired per `Hardware/bench-wiring` rev 0.3 and `BRING_UP.md` phases through CAN power; drive facts recorded (ruling R9b, R25a).

## Acceptance Criteria
- [ ] Evidence records per `EVIDENCE_RECORD_FORMAT.md` for SYS-MOT-001 (all powered; one unpowered), SYS-MOT-002 and SYS-TS-001, each carrying the `VERSION` identity from a clean build.
- [ ] Rows SYS-MOT-002 and SYS-TS-001 accepted by Lenton Neale in `SYSTEM_VERIFICATION_MATRIX.md`; row SYS-MOT-001 accepted once its commanded-motion half is also evidenced (#65).
- [ ] Register item LIVE-18 closed.

## Verification / Evidence
The matrix rows above. Only the Karetao process sets `SYSTEM_VERIFIED`; component tests do not count.

## References
- `SYSTEM_VERIFICATION_MATRIX.md` rows SYS-MOT-001/002, SYS-TS-001; `PARAMETER_REGISTER.md` PRM-MOT-01/02
- `ARCHITECTURE_DECISIONS.md` rulings R17(a) instruments, R28
