LentonNeale/Karetao/icm-project/workspaces/issue-alignment-2026-10-15/body-63.md

> *This was generated by AI during triage.*
> Triage state: ready-for-agent (the brief is stories B108 and B111)

## Context
Charter goal 4. `SYS-CMD-001` (`SYSTEM_REQUIREMENTS.md`) defines single gated commands per motor through SET_MOTOR_COMMAND: ACK when the gate accepts and queues to CAN, NACK with the gate reason otherwise; ACK does not mean executed. Register item **LIVE-20 Gated motion X/Y/Z**; work package **WP14 Stage 4 code**. Supersedes the acknowledgement question in #49 and the API in #17.

## Scope
- Story B108: SET_MOTOR_COMMAND decoded, gated, mapped to MKS frames (ENABLE, DISABLE, controlled stop, MOVE_TO_POSITION F5H, MOVE_AT_VELOCITY F6H via `drive_protocol`), ACKed or NACKed with the per-input gate reason, in `spi_protocol.c`, `spi_protocol.py` and shared golden vectors (SPI-7, HOST-1, SPI-17; `SPI_SYSTEM_INTERFACE.md` §14).
- Story B111: the system-activate SPI message (value proposed 0x16) with ACK/NACK on both sides; activates services in dependency order then the motion lifecycle; clears global_motion_inhibit and the health YELLOW latch; Pi client support (ruling R19b).
- Story B109: motor command module, the MKS mapping per kind in the 31H position unit with registered speed and acceleration and the motor firmware version read, following the decisions "MKS motion commands" and "MKS multi-motor synchronisation" (a one-joint command is a batch of one).
- Lockstep rule: C and Python change together with their tests; `SPI_PAYLOAD_SCHEMA.md` and `SPI_SYSTEM_INTERFACE.md` versioned accordingly.

Out of scope: the gate's decision logic itself (companion issue, D-3), bench verification, calibration (ruling R26b: raw shaft angles).

## Acceptance Criteria
- [ ] Each command kind with the gate open is ACKed and its effect appears in the snapshot motor record; with the gate closed it is NACKed with the gate reason (`SYS-CMD-001` acceptance), shown by host tests.
- [ ] Golden-frame vectors asserted by both the C and Python suites (depends on stories B55 and B132, the single SPI response path).
- [ ] System-activate message defined in the SPI documents and implemented with golden vectors.
- [ ] HostTests, Debug build and Pi tests pass; `doc_check` clean; task stack check passes (new callbacks recorded in `tools/stack_depth.cfg`).

## Verification / Evidence
Host tests on both sides. Bench: one command per kind, in the companion issue `[LIVE-20] Verify gated motion on joints X, Y and Z`.

## References
- `SYSTEM_REQUIREMENTS.md` SYS-CMD-001; `HOST_SYSTEM_INTERFACE.md`; `SPI_SYSTEM_INTERFACE.md` §14
- `ARCHITECTURE_DECISIONS.md` rulings R18 to R24 and the decisions "MKS motion commands" and "MKS multi-motor synchronisation"; stories B108, B109, B111, B55, B132
- Superseded issues: #17, #49
