LentonNeale/Karetao/icm-project/workspaces/issue-alignment-2026-10-15/body-64.md

> *This was generated by AI during triage.*
> Triage state: ready-for-agent (the brief is stories B106, B107, B110, B112 and B129)

## Context
Decision D-3 (`ARCHITECTURE_DECISIONS.md`, "Motion gate", 2026-10-03) reduced the gate to five inputs: lifecycle ACTIVE, CAN ACTIVE, Pi link not stale (SYS-LINK-001), no global motion inhibit, motor ready. ClockSync validity, sensor validity, calibration validity and feedback freshness are not gate inputs. `motion_permission.c` today evaluates a superset and is not the single authority; the 2026-10-14 review findings GATE-1, GATE-2, GATE-10 and GATE-27 describe the gap. Register item **LIVE-20**; work package **WP14**. Supersedes #10, #18, #20, #23, #26, #27.

## Scope
- Story B106: gate module rebuilt to D-3, per motor, side-effect free, the single motion authority every motor command passes; detail codes 0 ALLOWED to 6 CAN_QUEUE_FULL in precedence with a latched flag (ruling R18); motor_ready and global_motion_inhibit as defined in ruling R20.
- Story B107: count-based `link_stale` on STM32 local time with Provisional N symbols (SYS-LINK-001, PRM-LINK-02, Issue #12 item 11, ruling R22).
- Story B110: fail-closed supervisor: controlled stop then hold (stopped and enabled, ruling R21d) on a gate-closed edge; queue purge; controlled stop to every registered motor at boot and on CAN activation (ruling R23); MKS 98H heartbeat configured.
- Story B129: system lifecycle module owning the R19 motion lifecycle, the R20 global inhibit latch and dependency-ordered activation; reset or recovery never resumes motion (SAFE-04, SYS-REC-001).
- Story B112: fault visibility fields for SAFE-05 (GATE-23).

Depends on the WP17 requirement amendment (story B126) for the stop-and-hold wording.

## Acceptance Criteria
- [ ] With each gate input removed in turn, SET_MOTOR_COMMAND is NACKed with that input's reason code; with all present it is ACKed (`SYS-GATE-001` acceptance), shown by host tests.
- [ ] No motor command path bypasses the gate module (the #27 inventory, now a host test: boot queues no motion).
- [ ] WP14 acceptance lines for B106, B110, B129 met; `FIRMWARE_ARCHITECTURE.md` updated for the new module and task model.
- [ ] HostTests, Debug build and Pi tests pass; `doc_check` clean; task stack check passes with `tools/stack_depth.cfg` updated for new indirect calls.

## Verification / Evidence
Host tests per input. Bench: link-loss stop with the shaft held, in the companion verification issue.

## References
- `SYSTEM_REQUIREMENTS.md` SYS-GATE-001, SYS-LINK-001/002, SYS-REC-001; `SAFETY_REQUIREMENTS.md` SAFE-02, SAFE-04, SAFE-05
- `ARCHITECTURE_DECISIONS.md` D-3, rulings R18 to R23; stories B105 (rulings, done), B106, B107, B110, B112, B129, B126
- Superseded issues: #10, #18, #20, #23, #26, #27
