LentonNeale/Karetao/icm-project/workspaces/issue-alignment-2026-10-15/body-66.md

> *This was generated by AI during triage.*
> Triage state: ready-for-agent (the brief is stories B75 and B76)

## Context
Charter goal 1: an unfitted axis is a state on the wire, not a fault. Register item **LIVE-17 Fitted-encoder reading** (`KARETAO_DECISIONS_QUESTIONS_ISSUES_REGISTER.md` §0), which absorbed #48. The alignment plan (row S2.5) asked for an issue titled "Implement NOT_FITTED sensor status (C, Python, tests)"; the implementation now exists, so this issue covers only what is still unmet.

**Already implemented (checked 2026-10-15):** validity bit 6 `SPI_SENSOR_VALIDITY_NOT_FITTED` in `spi_payload_layout.h` and `SENSOR_VALIDITY_NOT_FITTED` in `spi_protocol.py`; `SensorTask_ConfigureFittedAxes` and the per-axis skip in `sensor_task.c`; `SensorLatestValue_SetNotFitted`; the `encoder_fitted` column of the commissioning table in `app_init.c`; decode tests in `protocol_test_main.c`, `service_test_main.c` and `test_spi_protocol.py`. Work package WP2 was reopened on 2026-10-14 by ruling R29(b) only for the bench evidence and LIVE-17 closure.

## Scope
From work package **WP10 Stage 1 code** in `icm-project/lifecycle.json`:
- Story B76: Stage 1 host tests that a valid sample reaches the wire, that a NOT_FITTED axis raises **no** health fault (`health_monitor.c` lines 49 to 63; the matrix row SYS-ENC-002 says "none yet for the NOT_FITTED behaviour"), and that a bad CRC is rejected (SYS-SPI-001 acceptance). Findings VER-30, VER-33, FW-31. Depends on story S9.7.
- Story B75: `Arm_Sensor_Hub/tools/check-sensors.sh` treats NOT_FITTED as expected rather than as a failure (lines 72 to 81 and 150 to 155; finding FW-21).
- Sensor timestamp taken immediately after the angle read (TIME-6, FW-9; story B72, which the AS5600 two-transaction sample of B133 satisfies) if not already landed by WP10.
- Note (2026-10-15): the latest-value store rework (B128) replaces `SensorLatestValue_SetNotFitted` with a per-axis fitted flag set once by `Configure`, so the NOT_FITTED host test should assert the wire result and the health result, not the setter.

Out of scope: filling the commissioning table and the bench records (companion issue); anything on the motor side (LIVE-18).

## Acceptance Criteria
- [ ] Host test: with an axis marked not fitted, the snapshot shows NOT_FITTED for that axis, `health_monitor` reports no sensor fault for it, and the other axes publish normally (`SYS-ENC-002` acceptance).
- [ ] Host test: a frame with a corrupted CRC is rejected.
- [ ] `check-sensors.sh` passes on a configuration with unfitted axes.
- [ ] `SYSTEM_VERIFICATION_MATRIX.md` row SYS-ENC-002 names the new tests.
- [ ] HostTests, Debug build and Pi tests pass; `doc_check` clean.

## Verification / Evidence
Host tests on both sides are the definition of done. Bench evidence is the companion issue `[LIVE-17] Verify fitted encoders read on the bench`.

## References
- `SYSTEM_REQUIREMENTS.md` SYS-ENC-001..003; `SPI_PAYLOAD_SCHEMA.md` sensor status; `SPI_SYSTEM_INTERFACE.md` §8
- `ARCHITECTURE_DECISIONS.md` D-10 (wire format), ruling R29
- Superseded issue: #48
