LentonNeale/Karetao/icm-project/workspaces/issue-alignment-2026-10-15/body-67.md

> *This was generated by AI during triage.*
> Triage state: ready-for-human (commissioning table and bench records are the maintainer's)

## Context
Register item **LIVE-17** closes when every fitted encoder is shown reading on the bench. Work package **WP2 Stage 1: fitted encoders** holds the Stage 1 evidence (reopened 2026-10-14 by ruling R29(b): the unmet lines are one accepted evidence record per fitted axis and LIVE-17 closed); the records are taken under **WP16 Bench bring-up** and filed against WP2.

## Scope
1. Commissioning table in `SYSTEM_CONFIGURATION.md` §2.1 filled by Lenton Neale: joint names, which axes carry an encoder, mux channel, motor mapping; `app_init.c` matches it (`SYS-ENC-003`, checked by inspection at merge).
2. Bench per `ENCODER_BENCH_PROCEDURE` (indexed under WP10): every fitted axis shows a valid reading that changes when the joint is moved, with a timestamp from the STM32 local clock (`SYS-ENC-001` acceptance).
3. The axes recorded as not fitted in `SYSTEM_CONFIGURATION.md` §2.1 (axes 0 and 3 on 2026-10-15): snapshot shows NOT_FITTED, no health fault, other axes publish normally (`SYS-ENC-002` acceptance). No axis needs to be re-marked for the test.
4. Pi dirty-tree rule and instruments per rulings R28(b) and R17(a).

Prerequisites: `BRING_UP.md` phases through sensor power and I2C; the companion implementation issue done so the NOT_FITTED host tests exist.

## Acceptance Criteria
- [ ] Commissioning table filled and versioned; `app_init.c` agrees.
- [ ] One evidence record per fitted axis per `EVIDENCE_RECORD_FORMAT.md`, plus one NOT_FITTED record, each with the `VERSION` identity from a clean build.
- [ ] Rows SYS-ENC-001, SYS-ENC-002, SYS-ENC-003 accepted by Lenton Neale in `SYSTEM_VERIFICATION_MATRIX.md`.
- [ ] Register item LIVE-17 and work package WP2 closed.

## Verification / Evidence
The matrix rows above; only the Karetao process sets `SYSTEM_VERIFIED`.

## References
- `SYSTEM_REQUIREMENTS.md` SYS-ENC-001..003; `SYSTEM_CONFIGURATION.md` §2.1; `Hardware/bench-wiring`; `BRING_UP.md`
- `ARCHITECTURE_DECISIONS.md` rulings R17, R28, R29
