LentonNeale/Karetao/icm-project/workspaces/issue-alignment-2026-10-15/comment-22.md

> *This was generated by AI during triage.*
> Triage state: wontfix

Correction (2026-10-15): the comment above says "heartbeat if ruled". Ruling R23 (`ARCHITECTURE_DECISIONS.md`, rulings table) has since ruled it. `motor_ready` is produced by the drive protocol module (story B131 superseded B111 for this; see #61), not B111. Work package references above are superseded by milestones and the project board.
