LentonNeale/Karetao/icm-project/workspaces/issue-alignment-2026-10-15/comment-29.md

> *This was generated by AI during triage.*
> Triage state: wontfix

Correction (2026-10-15): the comment above says "heartbeat if ruled". Ruling R23 (`ARCHITECTURE_DECISIONS.md`, rulings table) has since ruled it; the heartbeat behaviour is implemented under #61 and verified under #62. Work package references above are superseded by milestones and the project board.
