LentonNeale/Karetao/icm-project/workspaces/issue-alignment-2026-10-15/comment-43.md

> *This was generated by AI during triage.*
> Triage state: wontfix

Correction (2026-10-15): the comment above says the CAN bitrate stays Provisional until measured. Ruling R9(a) (`Documentation/07_DECISIONS/ARCHITECTURE_DECISIONS.md`, rulings table) has since decided 1 Mbit/s (`PRM-CAN-03`); Stage 3 measures bus load, termination and recovery, not the rate. The work package reference above is superseded: work above the issue level is tracked by milestones and the project board.
