LentonNeale/Karetao/icm-project/workspaces/issue-alignment-2026-10-15/comment-42-brief-corrections.md

> *This was generated by AI during triage.*
> Triage state: ready-for-agent

## Agent Brief corrections (2026-10-15 alignment check)

The Agent Brief above was checked against `ISSUE_12_CLOCK_SYNCHRONIZATION_DECISIONS.md`, ruling R16 in `ARCHITECTURE_DECISIONS.md`, the register and the backlog. Where they differ, the documents win. The body of this issue has been rewritten to match the rulings.

1. **"T4" names two instants.** The brief calls the STM32 receipt instant "T4 on the STM32 side" (after ruling R16, first clause) and also uses T4 for the Pi response receipt. `TIME_SYSTEM_INTERFACE.md` §3 and the Issue #12 record define T2 as the STM32 receipt (raw TIM2 at DMA-complete) and T4 as the Pi response receipt. Read the STM32 instant as T2. R16 was corrected to T2 in `ARCHITECTURE_DECISIONS.md` on 2026-10-15.
2. **Link liveness story.** The brief's out-of-scope line sends `link_stale` to "stories B106 and B110". Count-based `link_stale` is story B107 (S14.3) in #64; B106 is the gate module and B110 the fail-closed supervisor.
3. **Prerequisites are incomplete.** The brief lists B132, B130 and B55. B95 (record timestamps converted and marked) also depends on B88 (Pi motor-record decode, #61), and B96 overlaps B128: the latest-value store rework removes `synchronization_quality` and the TIMESTAMP_SYNCHRONIZED bit from the records and stops producers calling `TimeService_GetSyncSnapshot`, so B96 must follow or absorb that part of B128.
4. **ClockSync hook design differs from the documents.** The brief and stories B94/B130 (design note 2026-10-15) say `TimingSession` has no `ClockSync` dependency and its owner feeds `ClockSync` from `TransactionRecord`. Issue #12 item 4 and `SPI_SYSTEM_INTERFACE.md` §13 still say `TimingSession.transact()` calls `ClockSync.record_exchange()`. The design change is not recorded in `Documentation/`. Either the maintainer records it there, or the brief reverts to the documented form.
5. **Ruling letters not in the decision log.** The brief cites R16 sub-letters (a) to (j), for example (f) for the extension-gap guard behaviour (reply without the field, counter increments). The R16 row in `ARCHITECTURE_DECISIONS.md` has no letters and does not state the guard behaviour; the letters and that behaviour exist only in the backlog. The maintainer should record the guard behaviour in the decision log.
6. **Source documents not yet updated.** `ISSUE_12_CLOCK_SYNCHRONIZATION_DECISIONS.md` (items 8, 9, 11 and the sequencing list), `SPI_SYSTEM_INTERFACE.md` §12 and `SPI_PAYLOAD_SCHEMA.md` (DIAGNOSTIC v2) still describe DIAGNOSTIC v2 with ClockSync fields, a retained drift check and the open liveness parameters. The rulings (R14(d), R16, R22) supersede them; the brief follows the rulings.
7. **Open parameter missing from the brief.** The original body listed "ClockSync numeric acceptance criteria". Neither the brief nor any ruling or register row defines the plausibility thresholds; Gate A cannot be written without them.
8. **Plan-of-record references.** The brief cites work package WP12 and stories B91 to B99 in the ICM files. Those files are being retired; the acceptance criteria in this issue and the brief are the durable statement.
