LentonNeale/Karetao/Hardware/bench-wiring/karetao_bench_wiring.kicad_sch

## KiCad design Hardware/bench-wiring/karetao_bench_wiring.kicad_sch (2026-10-15)

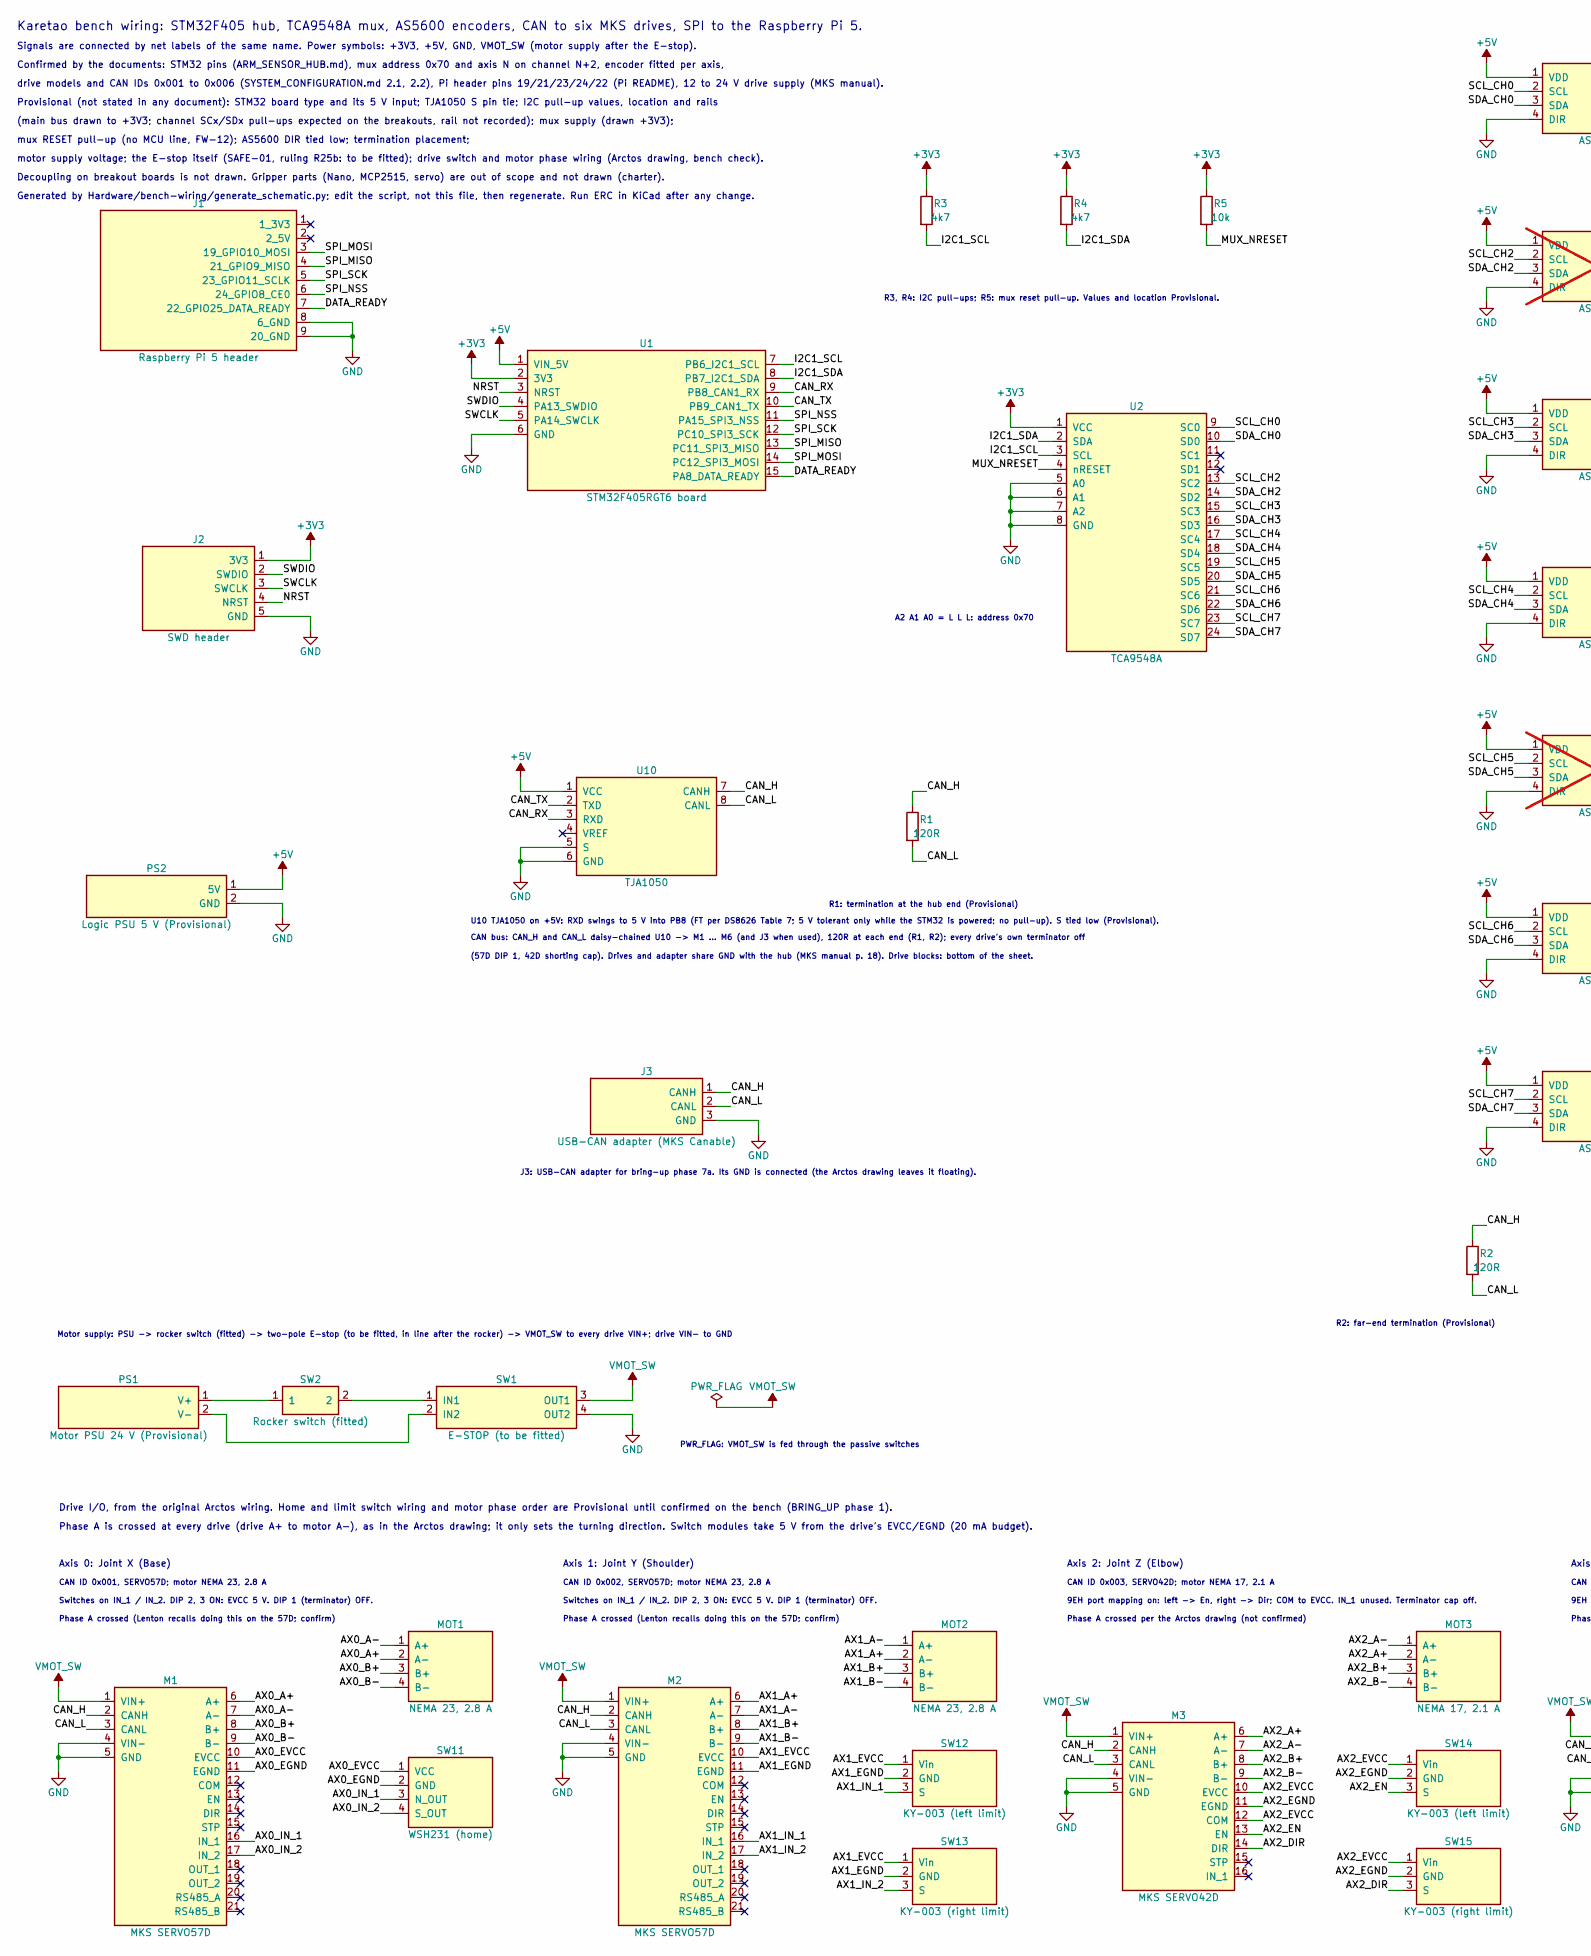
[picture p2: schematic karetao_bench_wiring.kicad_sch, part in row 1, column 1]

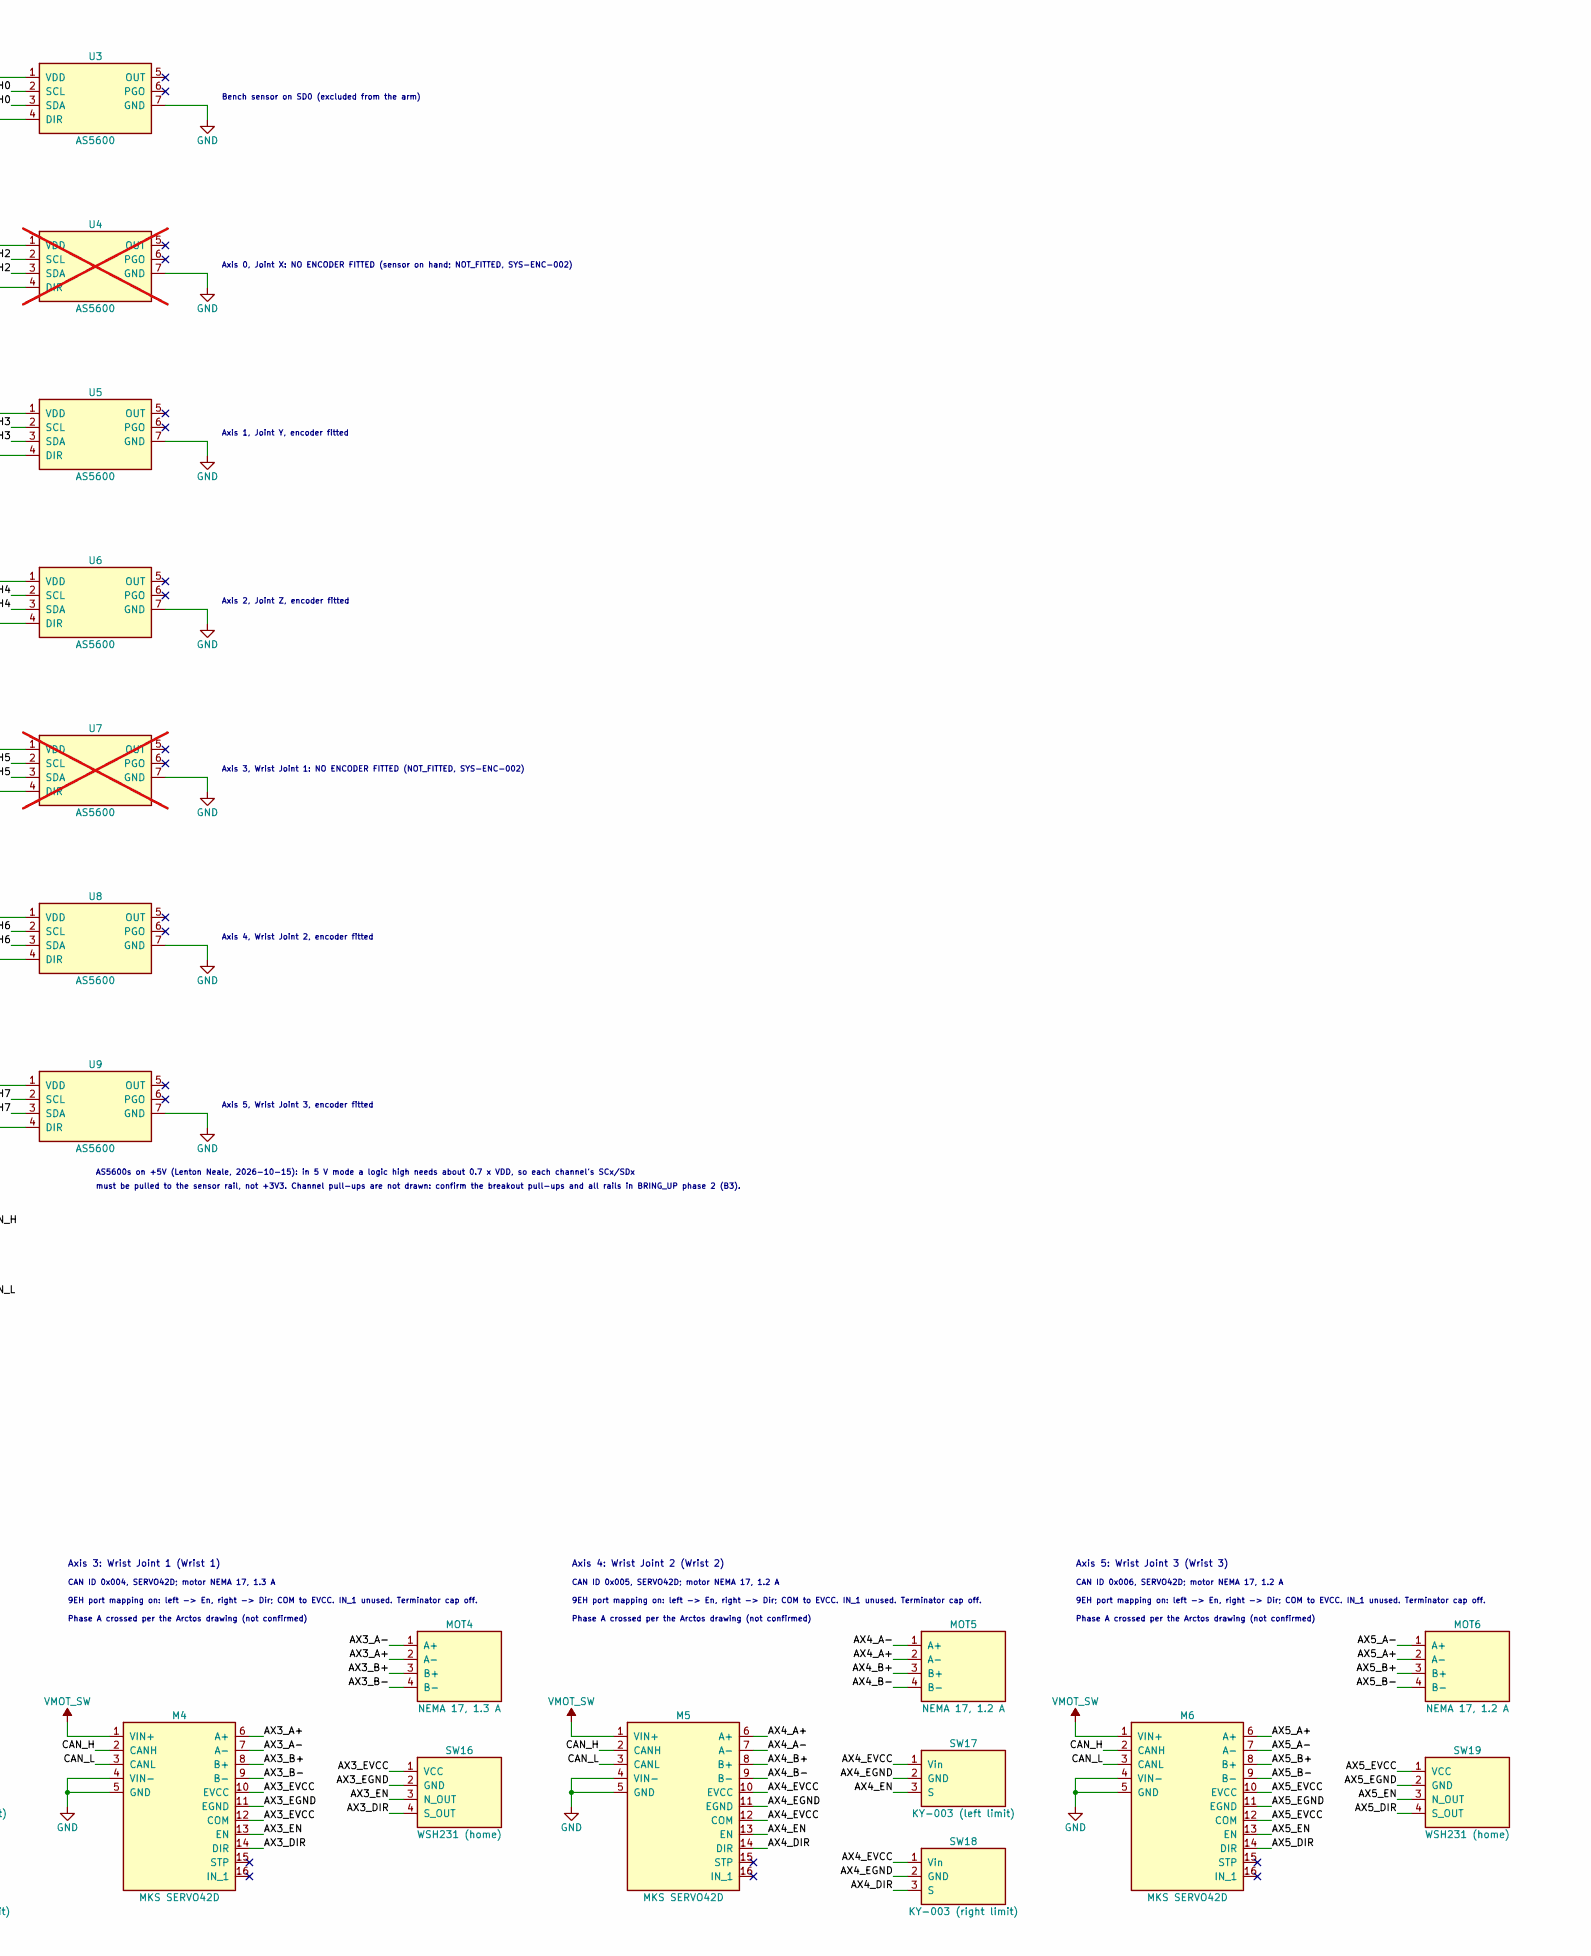
[picture p3: schematic karetao_bench_wiring.kicad_sch, part in row 1, column 2]

Parts:
J1: Raspberry Pi 5 header
J2: SWD header
J3: USB-CAN adapter (MKS Canable)
M1, M2: MKS SERVO57D
M3, M4, M5, M6: MKS SERVO42D
MOT1, MOT2: NEMA 23, 2.8 A
MOT3: NEMA 17, 2.1 A
MOT4: NEMA 17, 1.3 A
MOT5, MOT6: NEMA 17, 1.2 A
PS1: Motor PSU 24 V (Provisional)
PS2: Logic PSU 5 V (Provisional)
R1, R2: 120R
R3, R4: 4k7
R5: 10k
SW1: E-STOP (to be fitted)
SW2: Rocker switch (fitted)
SW11, SW16, SW19: WSH231 (home)
SW12, SW14, SW17: KY-003 (left limit)
SW13, SW15, SW18: KY-003 (right limit)
U1: STM32F405RGT6 board
U2: TCA9548A
U3, U5, U6, U8, U9: AS5600
U4, U7: AS5600; not fitted
U10: TJA1050

Connections:
+3V3: J2.1 (3V3), R3.1, R4.1, R5.1, U1.2 (3V3), U2.1 (VCC)
+5V: PS2.1 (5V), U1.1 (VIN_5V), U3.1 (VDD), U4.1 (VDD), U5.1 (VDD), U6.1 (VDD), U7.1 (VDD), U8.1 (VDD), U9.1 (VDD), U10.1 (VCC)
AX0_A+: M1.6 (A+), MOT1.2 (A-)
AX0_A-: M1.7 (A-), MOT1.1 (A+)
AX0_B+: M1.8 (B+), MOT1.3 (B+)
AX0_B-: M1.9 (B-), MOT1.4 (B-)
AX0_EGND: M1.11 (EGND), SW11.2 (GND)
AX0_EVCC: M1.10 (EVCC), SW11.1 (VCC)
AX0_IN_1: M1.16 (IN_1), SW11.3 (N_OUT)
AX0_IN_2: M1.17 (IN_2), SW11.4 (S_OUT)
AX1_A+: M2.6 (A+), MOT2.2 (A-)
AX1_A-: M2.7 (A-), MOT2.1 (A+)
AX1_B+: M2.8 (B+), MOT2.3 (B+)
AX1_B-: M2.9 (B-), MOT2.4 (B-)
AX1_EGND: M2.11 (EGND), SW12.2 (GND), SW13.2 (GND)
AX1_EVCC: M2.10 (EVCC), SW12.1 (Vin), SW13.1 (Vin)
AX1_IN_1: M2.16 (IN_1), SW12.3 (S)
AX1_IN_2: M2.17 (IN_2), SW13.3 (S)
AX2_A+: M3.6 (A+), MOT3.2 (A-)
AX2_A-: M3.7 (A-), MOT3.1 (A+)
AX2_B+: M3.8 (B+), MOT3.3 (B+)
AX2_B-: M3.9 (B-), MOT3.4 (B-)
AX2_DIR: M3.14 (DIR), SW15.3 (S)
AX2_EGND: M3.11 (EGND), SW14.2 (GND), SW15.2 (GND)
AX2_EN: M3.13 (EN), SW14.3 (S)
AX2_EVCC: M3.10 (EVCC), M3.12 (COM), SW14.1 (Vin), SW15.1 (Vin)
AX3_A+: M4.6 (A+), MOT4.2 (A-)
AX3_A-: M4.7 (A-), MOT4.1 (A+)
AX3_B+: M4.8 (B+), MOT4.3 (B+)
AX3_B-: M4.9 (B-), MOT4.4 (B-)
AX3_DIR: M4.14 (DIR), SW16.4 (S_OUT)
AX3_EGND: M4.11 (EGND), SW16.2 (GND)
AX3_EN: M4.13 (EN), SW16.3 (N_OUT)
AX3_EVCC: M4.10 (EVCC), M4.12 (COM), SW16.1 (VCC)
AX4_A+: M5.6 (A+), MOT5.2 (A-)
AX4_A-: M5.7 (A-), MOT5.1 (A+)
AX4_B+: M5.8 (B+), MOT5.3 (B+)
AX4_B-: M5.9 (B-), MOT5.4 (B-)
AX4_DIR: M5.14 (DIR), SW18.3 (S)
AX4_EGND: M5.11 (EGND), SW17.2 (GND), SW18.2 (GND)
AX4_EN: M5.13 (EN), SW17.3 (S)
AX4_EVCC: M5.10 (EVCC), M5.12 (COM), SW17.1 (Vin), SW18.1 (Vin)
AX5_A+: M6.6 (A+), MOT6.2 (A-)
AX5_A-: M6.7 (A-), MOT6.1 (A+)
AX5_B+: M6.8 (B+), MOT6.3 (B+)
AX5_B-: M6.9 (B-), MOT6.4 (B-)
AX5_DIR: M6.14 (DIR), SW19.4 (S_OUT)
AX5_EGND: M6.11 (EGND), SW19.2 (GND)
AX5_EN: M6.13 (EN), SW19.3 (N_OUT)
AX5_EVCC: M6.10 (EVCC), M6.12 (COM), SW19.1 (VCC)
CAN_H: J3.1 (CANH), M1.2 (CANH), M2.2 (CANH), M3.2 (CANH), M4.2 (CANH), M5.2 (CANH), M6.2 (CANH), R1.1, R2.1, U10.7 (CANH)
CAN_L: J3.2 (CANL), M1.3 (CANL), M2.3 (CANL), M3.3 (CANL), M4.3 (CANL), M5.3 (CANL), M6.3 (CANL), R1.2, R2.2, U10.8 (CANL)
CAN_RX: U1.9 (PB8_CAN1_RX), U10.3 (RXD)
CAN_TX: U1.10 (PB9_CAN1_TX), U10.2 (TXD)
DATA_READY: J1.7 (22_GPIO25_DATA_READY), U1.15 (PA8_DATA_READY)
GND: J1.8 (6_GND), J1.9 (20_GND), J2.5 (GND), J3.3 (GND), M1.4 (VIN-), M1.5 (GND), M2.4 (VIN-), M2.5 (GND), M3.4 (VIN-), M3.5 (GND), M4.4 (VIN-), M4.5 (GND), M5.4 (VIN-), M5.5 (GND), M6.4 (VIN-), M6.5 (GND), PS2.2 (GND), SW1.4 (OUT2), U1.6 (GND), U2.5 (A0), U2.6 (A1), U2.7 (A2), U2.8 (GND), U3.4 (DIR), U3.7 (GND), U4.4 (DIR), U4.7 (GND), U5.4 (DIR), U5.7 (GND), U6.4 (DIR), U6.7 (GND), U7.4 (DIR), U7.7 (GND), U8.4 (DIR), U8.7 (GND), U9.4 (DIR), U9.7 (GND), U10.5 (S), U10.6 (GND)
I2C1_SCL: R3.2, U1.7 (PB6_I2C1_SCL), U2.3 (SCL)
I2C1_SDA: R4.2, U1.8 (PB7_I2C1_SDA), U2.2 (SDA)
MUX_NRESET: R5.2, U2.4 (nRESET)
NRST: J2.4 (NRST), U1.3 (NRST)
unnamed: PS1.1 (V+), SW2.1
unnamed: PS1.2 (V-), SW1.2 (IN2)
unnamed: SW1.1 (IN1), SW2.2
SCL_CH0: U2.9 (SC0), U3.2 (SCL)
SCL_CH2: U2.13 (SC2), U4.2 (SCL)
SCL_CH3: U2.15 (SC3), U5.2 (SCL)
SCL_CH4: U2.17 (SC4), U6.2 (SCL)
SCL_CH5: U2.19 (SC5), U7.2 (SCL)
SCL_CH6: U2.21 (SC6), U8.2 (SCL)
SCL_CH7: U2.23 (SC7), U9.2 (SCL)
SDA_CH0: U2.10 (SD0), U3.3 (SDA)
SDA_CH2: U2.14 (SD2), U4.3 (SDA)
SDA_CH3: U2.16 (SD3), U5.3 (SDA)
SDA_CH4: U2.18 (SD4), U6.3 (SDA)
SDA_CH5: U2.20 (SD5), U7.3 (SDA)
SDA_CH6: U2.22 (SD6), U8.3 (SDA)
SDA_CH7: U2.24 (SD7), U9.3 (SDA)
SPI_MISO: J1.4 (21_GPIO9_MISO), U1.13 (PC11_SPI3_MISO)
SPI_MOSI: J1.3 (19_GPIO10_MOSI), U1.14 (PC12_SPI3_MOSI)
SPI_NSS: J1.6 (24_GPIO8_CE0), U1.11 (PA15_SPI3_NSS)
SPI_SCK: J1.5 (23_GPIO11_SCLK), U1.12 (PC10_SPI3_SCK)
SWCLK: J2.3 (SWCLK), U1.5 (PA14_SWCLK)
SWDIO: J2.2 (SWDIO), U1.4 (PA13_SWDIO)
VMOT_SW: M1.1 (VIN+), M2.1 (VIN+), M3.1 (VIN+), M4.1 (VIN+), M5.1 (VIN+), M6.1 (VIN+), SW1.3 (OUT1)

Notes on the sheet:
R3, R4: I2C pull-ups; R5: mux reset pull-up. Values and location Provisional.
A2 A1 A0 = L L L: address 0x70
Bench sensor on SD0 (excluded from the arm)
Axis 0, Joint X: NO ENCODER FITTED (sensor on hand; NOT_FITTED, SYS-ENC-002)
Axis 1, Joint Y, encoder fitted
Axis 2, Joint Z, encoder fitted
Axis 3, Wrist Joint 1: NO ENCODER FITTED (NOT_FITTED, SYS-ENC-002)
Axis 4, Wrist Joint 2, encoder fitted
Axis 5, Wrist Joint 3, encoder fitted
AS5600s on +5V (Lenton Neale, 2026-10-15): in 5 V mode a logic high needs about 0.7 x VDD, so each channel's SCx/SDx
must be pulled to the sensor rail, not +3V3. Channel pull-ups are not drawn: confirm the breakout pull-ups and all rails in BRING_UP phase 2 (B3).
R1: termination at the hub end (Provisional)
U10 TJA1050 on +5V: RXD swings to 5 V into PB8 (FT per DS8626 Table 7; 5 V tolerant only while the STM32 is powered; no pull-up). S tied low (Provisional).
CAN bus: CAN_H and CAN_L daisy-chained U10 -> M1 ... M6 (and J3 when used), 120R at each end (R1, R2); every drive's own terminator off
(57D DIP 1, 42D shorting cap). Drives and adapter share GND with the hub (MKS manual p. 18). Drive blocks: bottom of the sheet.
J3: USB-CAN adapter for bring-up phase 7a. Its GND is connected (the Arctos drawing leaves it floating).
Drive I/O, from the original Arctos wiring. Home and limit switch wiring and motor phase order are Provisional until confirmed on the bench (BRING_UP phase 1).
Phase A is crossed at every drive (drive A+ to motor A-), as in the Arctos drawing; it only sets the turning direction. Switch modules take 5 V from the drive's EVCC/EGND (20 mA budget).
Axis 0: Joint X (Base)
CAN ID 0x001, SERVO57D; motor NEMA 23, 2.8 A
Phase A crossed (Lenton recalls doing this on the 57D; confirm)
Switches on IN_1 / IN_2. DIP 2, 3 ON: EVCC 5 V. DIP 1 (terminator) OFF.
Axis 1: Joint Y (Shoulder)
CAN ID 0x002, SERVO57D; motor NEMA 23, 2.8 A
Axis 2: Joint Z (Elbow)
CAN ID 0x003, SERVO42D; motor NEMA 17, 2.1 A
Phase A crossed per the Arctos drawing (not confirmed)
9EH port mapping on: left -> En, right -> Dir; COM to EVCC. IN_1 unused. Terminator cap off.
Axis 3: Wrist Joint 1 (Wrist 1)
CAN ID 0x004, SERVO42D; motor NEMA 17, 1.3 A
Axis 4: Wrist Joint 2 (Wrist 2)
CAN ID 0x005, SERVO42D; motor NEMA 17, 1.2 A
Axis 5: Wrist Joint 3 (Wrist 3)
CAN ID 0x006, SERVO42D; motor NEMA 17, 1.2 A
R2: far-end termination (Provisional)
PWR_FLAG: VMOT_SW is fed through the passive switches
Motor supply: PSU -> rocker switch (fitted) -> two-pole E-stop (to be fitted, in line after the rocker) -> VMOT_SW to every drive VIN+; drive VIN- to GND
Karetao bench wiring: STM32F405 hub, TCA9548A mux, AS5600 encoders, CAN to six MKS drives, SPI to the Raspberry Pi 5.
Signals are connected by net labels of the same name. Power symbols: +3V3, +5V, GND, VMOT_SW (motor supply after the E-stop).
Confirmed by the documents: STM32 pins (ARM_SENSOR_HUB.md), mux address 0x70 and axis N on channel N+2, encoder fitted per axis,
drive models and CAN IDs 0x001 to 0x006 (SYSTEM_CONFIGURATION.md 2.1, 2.2), Pi header pins 19/21/23/24/22 (Pi README), 12 to 24 V drive supply (MKS manual).
Provisional (not stated in any document): STM32 board type and its 5 V input; TJA1050 S pin tie; I2C pull-up values, location and rails
(main bus drawn to +3V3; channel SCx/SDx pull-ups expected on the breakouts, rail not recorded); mux supply (drawn +3V3);
mux RESET pull-up (no MCU line, FW-12); AS5600 DIR tied low; termination placement;
motor supply voltage; the E-stop itself (SAFE-01, ruling R25b: to be fitted); drive switch and motor phase wiring (Arctos drawing, bench check).
Decoupling on breakout boards is not drawn. Gripper parts (Nano, MCP2515, servo) are out of scope and not drawn (charter).
Generated by Hardware/bench-wiring/generate_schematic.py; edit the script, not this file, then regenerate. Run ERC in KiCad after any change.
