LentonNeale/Karetao/Arm_Sensor_Hub/App/Inc/app_init.h

/**
 * @file app_init.h
 * @brief Implements the app init module.
 */

#ifndef APP_INIT_H
#define APP_INIT_H

#include <stdbool.h>
#include <stdint.h>

#ifdef __cplusplus
extern "C" {
#endif

/**
 * @brief Executes app init.
 */
void App_Init(void);
/**
 * @brief Executes app start.
 */
void App_Start(void);
uint32_t App_GetMksRegisterFailureCount(void);
uint32_t App_GetLifecycleActivationFailureCount(void);
/** Non-zero when the commissioned sensor axis-to-mux-channel map was rejected. */
uint32_t App_GetSensorConfigureFailureCount(void);

#ifdef __cplusplus
}
#endif

#endif /* APP_INIT_H */
