LentonNeale/Karetao/(commit log)

2026-09-07 Implement SPI time sync path
2026-09-07 Add SPI component comments
2026-09-08 feat: complete SPI snapshot staging path
2026-09-08 Consolidate docs and scaffold Raspberry Pi SPI
2026-09-08 Tighten workflow permissions
2026-09-08 Add SPI options engineer report
2026-09-08 Add separate SPI response email
2026-09-08 Add SPI options engineering assessment document
2026-09-10 Updated RAspberry pi bring up document to use cloud-init for replicatable image.
2026-09-15 Implement Raspberry Pi SPI0 backend
2026-09-15 Align SPI device with pipelined 512-byte transport
2026-09-15 Complete SPI3 slave DMA transaction path
2026-09-15 Keep SPI completion path independent of RTOS critical macros
2026-09-15 Enforce SPI protocol version on Pi
2026-09-15 Accept fixed 512-byte padded SPI transfers
2026-09-15 Freeze Raspberry Pi SPI0 hardware mapping
2026-09-15 Test fixed-size SPI transport framing
2026-09-15 Implement six-channel sensor acquisition
2026-09-15 Remove undefined sensor settle placeholder
2026-09-17 Restore target build, land armed-then-assert DMA, add configurable sensor mux mapping
    Two related work items verified together against host tests, target
    builds, and real STM32F405 hardware over ST-Link/V2.1.
    SPI3 DMA build restoration:
    - Declare `extern SPI_HandleTypeDef hspi3` in spi_slave_service.c so the
    service compiles against the real handle, matching the CAN/I2C pattern.
    - Add SPI types/tokens/prototypes to the host HAL stub so
    service_smoke_tests can exercise the DMA arm/complete/error/stall loop.
    - Rework the DATA_READY model to armed-then-assert (approved decision):
    the pin now rises only once a frame is handed to DMA and the transfer
    is armed, not merely staged, so the h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
2026-09-17 docs: reconcile SPI service contract with DMA implementation
2026-09-17 docs: reconcile SPI contract with DMA and DATA_READY state
2026-09-17 docs: reconcile commissioned six-axis sensor mapping
2026-09-17 docs: update Raspberry Pi SPI backend status
2026-09-17 docs: reconcile ARM build contract with CI
2026-09-17 docs: refresh ARM hardware baseline status
2026-09-17 docs: consolidate project documentation and archive stale material
2026-09-18 docs: establish documentation framework
2026-09-18 docs: link authority model from framework index
2026-09-18 docs: align framework with approved structure
2026-09-18 docs: establish Karetao documentation framework
2026-09-18 docs: complete documentation framework
2026-09-18 docs: finalize documentation framework authority rules
2026-09-18 docs: populate system authority document (RASPBERRY_SENSOR_HUB.md)
2026-09-18 Add SPI cable length and physical-link verification requirement
2026-09-20 added workspace file to set the STM32 cmake dir to the ARM_Sensor_Hub
2026-09-20 WP-2: Fix implementation checklist scope lines to match Option (a) decision
    Update checklist to reflect that:
    - Component repositories receive Documentation/ directories with authority declarations
    - Archive content from docs/project/archive/** is migrated (not excluded)
    Initialize refactoring ledger recording WP-1 decisions and pre-made conflict resolutions.
2026-09-20 WP-3a: Expand SPI system interface from legacy contracts
    Expand 02_INTERFACES/SPI/SPI_SYSTEM_INTERFACE.md from 23-line stub to comprehensive system contract covering:
    - Framing: fixed 512-byte transaction, 490-byte max payload, CRC-32/ISO-HDLC (C-3 frame size corrected)
    - Transaction model: pipelined request/response with sequence correlation
    - Message types: SNAPSHOT, EVENT, DIAGNOSTIC, GET_SNAPSHOT, GET_STATUS, TIME_SYNC, SET_MOTOR_COMMAND, ACK, NACK
    - DATA_READY semantics: armed-then-assert model per C-1 decision (supersedes CONTRACT_V1_FREEZE.md)
    - Snapshot coherency: fixed six-record target, replace-if-new semantics, drop diagnostics
    - Time domain: Pi authority, STM32 monotonic local cl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
2026-09-20 WP-3b: Expand TIME system interface from legacy synchronization contract
    Expand 02_INTERFACES/TIME/TIME_SYSTEM_INTERFACE.md from 20-line stub to comprehensive time synchronization contract covering:
    - Time model: hub_time_us = local_time_us + time_offset_us formula; Pi as time authority; STM32 monotonic local clock never reset by sync
    - Measurement vs. frame timestamps: acquisition time domain vs. frame assembly time; local-only marking until first sync
    - TIME_SYNC transaction: payload structure (pi_time_us, sync_seq, flags); STM32 offset calculation and atomic state update
    - Acceptance criteria: initial ±24-hour bound, runtime ±1-second bound, sequence validation, rejection without silent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
2026-09-20 WP-3c: Expand CAN system interface from legacy service contract
    Expand 02_INTERFACES/CAN/CAN_SYSTEM_INTERFACE.md from 20-line stub to comprehensive CAN system contract covering:
    - Configuration: 11-bit IDs, 1 Mbps target, 50–60% bus load target, motor capacity, ID uniqueness requirement
    - Motor command lifecycle gating: only ACTIVE state permits transmission; explicit reactivation after recovery
    - TX queue semantics: priority ordering (SAFETY > MOTION > POLL), three-retry bound on HAL failure, queue-full rejection, frame ordering
    - RX handling: frame validation, unregistered ID ignoring, decode failures mark cache stale without corrupting payload
    - Bus-off policy: detection and escalating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
2026-09-20 WP-4: Build out 01_SYSTEM/ and 06_CONFIGURATION/ with lifecycle, architecture, and configuration
    Create 01_SYSTEM/SYSTEM_LIFECYCLE.md (new, 280 lines):
    - Canonical lifecycle states (UNCONFIGURED, INACTIVE, ACTIVE, ERROR) and transitions
    - Fault convention: firmware response levels (INFORMATIONAL/DEGRADED/FAULT/SAFETY_CRITICAL) with explicit "not a PL/SIL mapping" caveat
    - Fault classes: transient, persistent, fatal, configuration
    - Escalation policy: classify → retry budget → enter ERROR → recover to INACTIVE → require explicit activation
    - Safety gates: time-dependent motion inhibited after TIME_SYNC expiry (5 seconds)
    - Subsystem mapping and dependency rules
    - Startup sequence: HAL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
2026-09-20 WP-5: Complete 03_COMPONENTS/ with system-visible Arm Sensor Hub facts
    Expand 03_COMPONENTS/ARM_SENSOR_HUB.md from 20-line stub to 90-line system-level component document including:
    System-visible hardware baseline:
    - MCU family: STM32F405RGT6 (LQFP64)
    - Clock tree: 8 MHz HSE → 168 MHz SYSCLK; APB1 42 MHz (constrains CAN/SPI), APB2 84 MHz
    - Timing constraints: CAN nominally 1 Mbps (integration ceiling), SPI nominally 5 MHz (integration ceiling), sensor sweep ~46 ms
    System-visible interface pin assignments (other components depend on these):
    - I2C1: PB6 (SCL), PB7 (SDA), 400 kHz fast mode
    - CAN1: PB8 (RX), PB9 (TX), ISO 11898-1 (500 kHz–1 Mbps)
    - SPI3: PA15 (NSS), PC10 (SCK), PC11 (MISO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
2026-09-20 WP-6: Create component documentation directories with authority declarations
    Create Arm_Sensor_Hub/Documentation/ and RaspberryPi_Sensor_Hub/Documentation/ as monorepo component directories per Option (a) decision.
    Each component directory receives README.md with authority declaration:
    Arm_Sensor_Hub/Documentation/README.md:
    - Identifies Arm Sensor Hub as STM32F405RGT6 firmware component
    - Declares component implementation authority: service architecture (I2CManager, CAN Service, SPI Slave Service, Sensor Task, HealthMonitor), firmware APIs, HAL/DMA, FreeRTOS, build system, diagnostics/testing
    - References Karetao system authority by stable identifiers (SYS-*, SD-*), never copying requirem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
2026-09-20 WP-7: Archive historical content from docs/project/ with archive headers
    Create 99_ARCHIVE subdirectories for historical content and move ~4,600 lines of archival material using git mv.
    99_ARCHIVE/CONVERSATIONS/ (1,200 lines):
    - CTO_DECISION_BRIEF.md, CTO_DECISION_FINAL.md (approval narrative and formal CTO sign-off)
    - DeepSeek.md, GPT.md, InterAgent_Chat.md (AI-assisted design exploration)
    - 2026-09-08-spi-options-engineering-assessment.md (engineering analysis)
    Special handling: CTO_DECISION_FINAL.md marked as "approval origin for SD-01–SD-25, not merely a conversation"
    99_ARCHIVE/SPRINTS/ (~300 lines):
    - Sprint_1_List.md (sprint planning, obsolete)
    - Sprint_2_Readiness_Report.md (spri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
2026-09-20 WP-8: Verification gate before docs/ removal - all acceptance criteria met
    Create 07_DECISIONS/ARCHITECTURE_DECISIONS.md placeholder (C-4 resolution):
    - Links from archived SYSTEM_DECISIONS.md now resolve
    - Points to current decision register for architecture decisions
    - Fulfills C-4 requirement without establishing competing authority
    Verification results:
    ✓ Acceptance criterion 1: All normative/factual statements accounted for
    - Distributed across Documentation/** (WP-2 through WP-7)
    - Archived with headers in 99_ARCHIVE/
    - Recorded in KARETAO_DECISIONS_QUESTIONS_ISSUES_REGISTER.md
    - Ledger documents all deliberate exclusions and reasons
    ✓ Acceptance criterion 2: Authority mo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
2026-09-20 WP-9: Update entry points and remove legacy docs/ directory
    - Root README.md: removed references to docs/project/ as legacy/transitional material
    - Documentation/00_INDEX.md: updated framework status from "Active reconciliation/refactor" to "Complete"
    - DOCUMENTATION_AUTHORITY_MODEL.md: updated cross-document authority transition section to reflect completion
    All entry points now correctly establish Documentation/** as the sole authority framework. The legacy docs/ directory is removed as all content has been migrated and verified via the WP-8 gate.
2026-09-20 Remove legacy docs/ directory - migration to Documentation/** complete
    All legacy content from docs/project/** has been migrated to the Documentation/** framework during WP-2 through WP-8. The verification gate (WP-8) confirmed all acceptance criteria are met:
    ✓ No orphaned statements
    ✓ No new authority introduced
    ✓ Verification evidence properly separated
    ✓ Provisional qualifiers preserved
    ✓ Links resolve correctly
    ✓ Implementable from Karetao alone
    The legacy docs/ directory is no longer needed and is removed.
2026-09-20 Rewrite Raspberry Pi bring-up guide; assign DATA_READY harness candidate; add I2C timing analysis
    Raspberry Pi bring-up (RaspberryPi_Sensor_Hub/Documentation/):
    - Replace RASPBERRY_PI_BRINGUP_V0.1.md with V1: reconcile the guide
    against current Karetao system requirements/contracts, remove
    references to superseded docs (SPI_CONTRACT.md, LIFECYCLE_CONTRACT.md,
    the archived SAFETY_RELEASE_CHECKLIST.md), and correct component
    naming (the Pi hosts Raspberry Sensor Hub, not Arm Sensor Hub).
    - Add a version-controlled cloud-init user-data/meta-data/network-config
    seed covering SSH key-only login, real-time limits, CPU governor,
    chrony, and ROS 2 Jazzy install via the current ros2-apt-s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
2026-09-20 docs: trace motion-permission proposal
2026-09-20 docs: trace proposed motion permission safety boundary
2026-09-20 docs: add MKS SERVO42D/57D CAN synchronisation report
2026-09-21 docs: freeze DATA_READY GPIO25/PA8 assignment on the bench harness
    Record the header-pin/wire/STM32-pin mapping from the current test rig
    and move DATA_READY from "candidate" to "assigned and wired" in the
    Raspberry Pi Sensor Hub docs. SD-17's open issue is half-closed: the
    pin is now picked and wired, but electrical/timing acceptance per
    SPI_SYSTEM_INTERFACE.md §16 is still outstanding, so the system
    contract continues to leave the physical GPIO unspecified and the
    host remains polling-only at 1 ms.
2026-09-21 feat: implement GET_VERSION, SPI timing harness, and provisioning docs
    Implements bench-test infrastructure for SPI transport timing validation
    per SPI_SYSTEM_INTERFACE.md §16 integration gate. No real hardware tested yet.
    ## GET_VERSION (0x14) and VERSION (0x04) Response
    Adds firmware build identity reporting so bench evidence can be attributed
    to an exact firmware revision. Closes SD-17's "no version reporting" gap.
    - Firmware identity struct with major.minor.patch, git hash (abbrev),
    commit epoch, and dirty-build flag (set when uncommitted changes present)
    - CMake sources git identity at build time; reproducible across rebuilds
    - Host decoder extracts fields and exposes via VersionI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
2026-09-21 feat: DATA_READY GPIO pacing for SPI timing harness
    Bench testing showed unpaced back-to-back transactions return
    stale/zeroed frames (firmware's bare-metal main-loop needs time to
    re-arm DMA). Adds DataReadyWatcher (libgpiod v1) to wait on the wired
    GPIO25/PA8 signal, with a fixed-delay fallback when unused. Also makes
    get_version() tolerate a corrupted transfer mid-retry instead of
    raising, since unpaced transfers can be transiently garbled.
2026-09-21 fix: host restarting its seq counter was NACKed by the firmware
    The firmware accepts a request only if its seq is strictly newer than the
    last it accepted, and that high-water mark lives in RAM until the STM32 is
    power-cycled. Both host transmitters started their counter at a fixed 1, so
    only the first run against a powered board worked; every later run replayed
    sequences the firmware had already consumed and was rejected wholesale.
    SPI_SYSTEM_INTERFACE.md section 6 requires seq to increment monotonically
    per transmitter, so the host was the side at fault.
    Seed from wall-clock milliseconds, forcing seeds apart within a process
    where the clock alone cannot separate them. get_version() now al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
2026-09-21 feat: add SPI link probe to classify a non-responsive STM32
    get_version() retries past an undecodable transfer, which is right for an
    occasional glitch but collapses every persistent fault into one timeout: a
    silent MISO, a byte-shifted frame, a firmware that refuses the request and a
    firmware that never implements it are indistinguishable through the client.
    The probe keeps the raw bytes and names the fault instead.
2026-09-21 build: emit .bin and .hex so the firmware can actually be flashed
    The build produced only an ELF, which st-flash cannot consume, so
    `st-flash write build/Arm_Sensor_Hub.bin` failed on a file that was never
    generated and the board kept running whatever it had. Add an objcopy
    post-build step for both formats.
2026-09-21 fix: SPI link probe raced the firmware's main-loop DMA rearm
    The probe used a fixed --interval-ms sleep with no DATA_READY awareness.
    The firmware only rearms DMA for the next transfer when its bare-metal
    main loop next calls SpiSlaveService_Process(), not the instant the
    previous transfer completes, so a fixed delay is a guess at that timing
    rather than a guarantee of it -- exactly the race DATA_READY pacing was
    already built to solve for the timing harness. Add --data-ready to the
    probe and flag the corrupted-vs-rejected distinction in its verdict.
2026-09-21 Fixed probe script bug: Probe was not adhering to the use the expected use of the DATA_READY contract/Timing
2026-09-21 feat: Implement DATA_READY/SPI latency measurement and analysis
    Add detailed timing characterization for the pipelined SPI/DATA_READY
    transaction protocol per SPI_SYSTEM_INTERFACE.md sections 4, 7, 16.
    Changes:
    - Extend TransactionRecord with three DATA_READY timing fields (all in µs):
    * data_ready_to_nss_low_us: DATA_READY rise to NSS fall (transfer start latency)
    * nss_high_to_data_ready_low_us: NSS rise to DATA_READY fall (pipelined latency)
    * data_ready_interval_us: Time between consecutive DATA_READY rising edges
    - Add data_ready_latency_ms() method to TransactionRecord for convenient
    conversion of DATA_READY to NSS latency from µs to ms
    - Create new data_ready_analysis.py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
2026-09-21 feat: add TIME_SYNC measurement instrumentation and validation framework
    Adds STM32-side debug mirrors (TimeService_SyncDebugMirror,
    SpiSlaveService_TimingMirror) for SWD inspection of accepted-offset state
    and SPI transaction timing, and a Pi-side toolchain to drive and analyze
    TIME_SYNC measurements: payload encode/decode, TimeSyncSession offset and
    drift tracking, CSV logging, a probe CLI, and a multi-session repeatability
    harness.
    Also adds the SYS-SYNC/SYS-SPI/SYS-TIM requirement-to-evidence mapping,
    SWD readout procedures, and characterisation evidence documenting which
    clauses are verified by measurement versus still open pending firmware
    support for sending TIME_SYNC from the Pi.
    C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
2026-09-21 docs: add deployment guide and fix VS Code workspace configuration
    - Add UPDATE_GUIDE_STM32_AND_PI.md: comprehensive deployment guide covering
    STM32 firmware build/flash/verify and Raspberry Pi Python update steps,
    with end-to-end health check and rollback procedures.
    - Fix .code-workspace: remove stale workspace-level launch config that
    referenced non-existent openocd.cfg and wrong build output path
    (build/Arm_Sensor_Hub.elf instead of build/Debug/Arm_Sensor_Hub.elf).
    Now correctly delegates STM32 debug config to
    Arm_Sensor_Hub/.vscode/launch.json (cortex-debug + stlink verified).
    - Update .vscode/settings.json: add Claude Code panel/terminal preferences
    and CMake cube-cmake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
2026-09-22 docs: define four-decimal joint angle representation
2026-09-22 docs: update For_Lenton to current Karetao state
2026-09-23 docs: add formal issue framework
2026-09-23 docs: align issue framework with engineering project
2026-09-24 Create Issue #12 — Clock Synchronization: Final Decisions
2026-09-24 Update Issue #12 — Clock Synchronization: Final Decisions
2026-09-25 docs: remove archived and legacy material from the working tree
    Old conversations, superseded contracts and sprint reports were being
    read as current guidance. Git history is now the archive; the former
    Documentation/99_ARCHIVE/ is recoverable at 9c637ba.
    - Delete Documentation/99_ARCHIVE/, Agent_conversations/ and
    .github/Document Agent (every SD-01..SD-26 decision is still
    referenced from the active docs)
    - Update the index, authority model, refactoring rules and component
    model to point at Git history instead of 99_ARCHIVE/
    - Add notes to the refactoring ledger, plan and checklist that their
    99_ARCHIVE/ paths are historical
    - Fix dead docs/ and CMake links in development.md
    - Dro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
2026-09-25 docs: reconcile system docs with Issue #12 clock-sync decisions
    The Issue #12 decision record (2026-09-24) superseded SD-03, SD-19,
    SD-21 and SD-22, but about 15 older documents still stated the previous
    design as approved. Conflicts are resolved in favour of the newer
    decisions, except where a newer item is still open.
    - Rename the decision record to ISSUE_12_CLOCK_SYNCHRONIZATION_DECISIONS.md
    and link it from ARCHITECTURE_DECISIONS.md
    - STM32 does no clock math; every SPI response carries
    request_received_local_us as a ClockSync observation; the 5 s
    validity window is kept (SYS-SYNC-002/004/005, new SYS-SYNC-006)
    - SYS-FAIL-001: count-based link_stale liveness replaces the fixed
    h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
2026-09-25 docs: add CLAUDE.md with build commands and documentation rules
    Gives Claude Code the firmware and Pi build/test commands, the
    firmware data flow, the duplicated C/Python SPI frame format, and the
    Karetao documentation authority rules.
2026-09-25 feat(icm): add Haiku client-liaison intake session
    Long clarification conversations now happen on Haiku before any Opus
    work starts. The liaison runs as its own main session (a subagent can't
    talk to the user) and hands off through a brief file, as ICM intends.
    - workspace/agents/client-liaison.md: Haiku; tools Read/Glob/Grep/Write
    only; completeness checking only, never design decisions; "send it"
    escape hatch writes a ready-with-gaps brief
    - stages/01-intake/references/definition-of-ready.md: 10-item standard
    - stages/01-intake/CONTEXT.md: liaison runs steps 1-3, orchestrator
    accepts the brief on "take brief <slug>"
    - scripts/liaison.sh: claude --agent client-liaison --model haiku,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
2026-09-25 feat(icm): add dependency check and installer
    New machines and new projects can confirm or install the toolchain in
    one step instead of finding missing tools through failed builds.
    - workspace/scripts/check-deps.sh: checks commands or marker files from
    workspace/setup/deps.txt (workspace needs) and icm-project/deps.txt
    (project needs); --install shows the apt command and asks before
    running sudo; non-apt tools are listed with manual instructions
    - icm-project/deps.txt: Karetao's CI toolchain (cmake, ninja,
    build-essential, arm-none-eabi gcc/binutils, newlib, libstdc++)
    - setup/install.sh runs the check; the questionnaire and build.md point
    to it; a deps.txt template is added for n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
2026-09-25 test(icm): add client-liaison scenarios and fix brief format
    Four one-shot Haiku scenarios check the liaison against its contract:
    vague request (asks questions, no brief), complete request (ready
    brief), "send it" (ready-with-gaps brief with Gaps), and a design
    question (defers to the orchestrator). tests/liaison/run.sh runs them
    and keeps transcripts in a gitignored results/ folder.
    The first run showed the liaison writing the header as a table instead
    of `status:` lines, and adding an Owner field with the user's email.
    Fix: stages/01-intake/references/brief-template.md is now the exact
    format, and the agent must copy it with no extra fields or personal
    details. The runner also fails any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
2026-09-25 test(icm): add orchestrator delegation tests; always load Layer 0
    Five headless scenarios check that the Opus orchestrator picks the right
    executor on its own: full build -> build-runner (haiku); content audit
    -> doc-checker (sonnet); trivial lookup and scripted link check ->
    handled directly; issue creation without approval -> spec plus
    checkpoint, no issue-clerk and no GitHub writes. tests/delegation/run.sh
    reads the stream-json log (agents chosen, subagent models, main-session
    commands) and prints a token/cost split by model.
    Findings fixed:
    - Delegation depended on the session happening to open
    workspace/CLAUDE.md, which Claude Code only loads for that subfolder.
    The root CLAUDE.md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
2026-09-25 feat(icm): add Haiku subject-expert with SPI dossier pilot
    The orchestrator can now ask a cheap, read-only expert about a subject
    (specs, contracts, status, open decisions, file locations) instead of
    reading the documents and code on the main model.
    - workspace/agents/subject-expert.md: one generic Haiku agent. It
    answers only from icm-project/subjects/<subject>.md and what that
    points to; every answer is labelled documented / implemented /
    conflict / open / not documented with path:line sources, and it
    reports dossier gaps. It is an expert on the sources, not a source.
    - Dossier template for new projects; the delegation table and routing
    point questions to the expert; close-out (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
2026-09-25 fix(icm): make developer escalation a mandatory first-step gate
    Smoke test: c11-dev edited HAL_SPI_TxRxCpltCallback (ISR context) to
    add a field, reported DONE, and noted "in ISR context" in its own
    summary. It treated "Task (approved)" as overriding its escalation rules
    and never checked the rules against the code it edited.
    All three developer agents now run a Step 0 gate before any edit. It is
    stated to override approved plans, uses concrete detectors (ISR name
    patterns, callers traced with grep, volatile/DMA/RTOS data for C; C
    boundary for C++; shared interfaces and importers for Python), and the
    report must show the check.
    Re-test (Haiku):
    - c11-dev escalates the direct ISR edit, and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
2026-10-01 chore: set up the ICM Portal; remove the old ICM workspace
    Karetao now works through the current ICM Portal (LentonNeale/Karetao_Consulting),
    set up fresh:
    - portal.toml: run data, checklist and build worktrees kept outside the repo;
    Verify runs the same commands as CI (host tests, Debug build, Pi SPI tests);
    the code map skips vendor HAL/CMSIS and FreeRTOS; the Portal's shared
    workspaces for the Liaison, Review, Build and test checklist.
    - icm-project/: empty workspaces/, tools/, skills/, references/ and research/
    folders for Karetao's own ICM items, a README, and a short requester profile.
    - CLAUDE.md and README.md point at the Portal.
    Removed: the old workspace/ subtree, its .cl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
2026-10-02 chore(icm-project): add reference folders and route build and review stages to them
    Thirteen reference folders under icm-project/references/, built from official sources with the
    reference-intake rules and checked with check_reference and verify_citations: AS5600, TCA9548A,
    MKS SERVO42D/57D CAN V1.0.9, CAN 2.0, CRC-32/ISO-HDLC, STM32F4 HAL/CMSIS (CubeF4 V1.28.3),
    CMSIS-RTOS2, FreeRTOS V10.3.1, Linux spidev, Raspberry Pi 5 SPI/RP1, libgpiod v1.6.3, Arm GNU
    toolchain flags and CMake presets. Vendor PDFs stay in ~/.icm/sources/, recorded by sha256.
    Karetao copies of the implement-step and pre-merge-review workspaces add a shared
    references.md that maps each code area to its note; portal.toml p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
2026-10-02 Track the Portal backlog and the privacy terms file
    backlog.json is the Portal's user-story backlog for this project (as Meads_Game
    already tracks); icm-project/forbidden-terms.txt is the terms list the
    check-project-facts script reads before anything is pushed to the shared ICM repo.
2026-10-03 docs: sprint 0, wire the charter in
    Entry points name the charter as scope authority; the system overview is rewritten to the charter scope with a 'Future, not now' note; the Portal backlog carries the sprint stories. Files edited again in later sprints are committed there.
2026-10-03 docs: sprint 2, fitted encoders
    Evidence record format (D-9) and the Arm Sensor Hub component page trimmed to point at the commissioning table and the register. SYS-ENC requirements, the NOT_FITTED wire definition and the commissioning table are in files committed with later sprints.
2026-10-03 docs: sprint 3, motor positions and coherent timestamps
    CAN, TIME and SPI interface documents reference the register and drop the estimator; the architecture is at charter scope; the Pi component page describes what the host does; time-sync evidence stays as dated as-built records; the Issue #12 design is kept (D-2).
2026-10-03 docs: sprint 6, collapse documentation about documentation
    Index and DOCUMENTATION_RULES.md replace the authority model, component model, refactoring rules, plan, ledger, checklist and section stubs; research notes move to icm-project/; component documents lose stale references and ROS 2 authority claims; doc_check tool added and wired into the Portal verify list.
2026-10-03 Set up the Portal project: lifecycle work packages, baseline files, backlog normalised
    Turn on the mechatronics lifecycle profile in portal.toml and list the files the requirements
    and architecture baselines cover. lifecycle.json holds six work packages: WP1 the documentation
    alignment (its PASS at the Requirements gate is the sign-off of CHARTER_ALIGNMENT_PLAN.md
    section 3.9) and WP2 to WP6 the code-alignment Stages 1 to 5 from decision D-11, each with the
    acceptance the plan gives it.
    backlog.json used a status ("backlog") and integer sprint keys the Portal does not read. Stories
    S0 to S6, drafted outside the Portal on docs/charter-alignment on 2026-10-03 as the plan records,
    are now done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
2026-10-03 Document sign-off readiness status and Portal framework
    Added definition-of-done section documenting sign-off readiness: 4 of
    8 items hold, 2 don't hold, and 2 are blocked pending GitHub changes.
    Established ICM Portal project framework by linking this work (WP1) to
    lifecycle.json and mapping the five code-alignment stages as WP2–WP6.
    Four items await owner decision; see section 14.1 for details.
2026-10-04 portal.toml: scope Verify commands to their CI paths and allow jq
    The firmware and Pi Verify commands carry the same path filters as arm-ci.yml and
    raspberry-ci.yml. A build that changes neither records them as not applicable
    instead of PASS, which is what the L0 run's firmware build and 155 Python tests
    should have said about a documentation review. doc_check still always runs.
    jq is allowed so a check step can read a run's JSON record without python -c,
    which is refused.
    Needs the Portal with path-scoped commands (Karetao_Consulting fix/check-card-verdict).
2026-10-05 Record the backlog and work packages for WP2 Stage 1: fitted encoders
2026-10-05 Add encoder-fitted configuration and handling
    Define NOT_FITTED sensor flag (bit 6) for axes without encoders.
    Firmware commissioning table marks axis 3 unfitted; skip polling.
    Pi-side decoding: is_valid and is_not_fitted predicates added.
    SYSTEM_CONFIGURATION.md: encoder status documented for axes 0–5.
    ENCODER_BENCH_PROCEDURE.md: verification steps added.
2026-10-05 Record the backlog and work packages for Fix probe VERSION decoding
2026-10-05 Decode VERSION in spi_link_probe
    Add version_lines() helper to decode and display VERSION frames
    with firmware version, git hash, build flags (dirty bit), protocol
    version, and commit epoch. Update ENCODER_BENCH_PROCEDURE.md to use
    these field names (git_hash_abbrev, dirty) and --snapshot flag.
    Add test cases covering clean/dirty builds and invalid frames.
2026-10-05 Record the WP2 Verification gate pass and the probe follow-up run
2026-10-05 Record the backlog and work packages for Fix version_lines() output on bad magic or CRC frames
2026-10-05 Return empty version line on bad SPI frame magic or CRC
    Probe tool printed misleading "VERSION payload undecodable" messages
    for frames with bad start markers or checksums. version_lines() now
    returns [] when frame decoding fails, distinguishing frame errors from
    payload errors. Added tests for bad magic and bad CRC.
2026-10-06 Drop WP3 to WP6: code alignment to be re-cut from a gap audit
2026-10-06 Add WP8 code-versus-documentation audit and stories B45 to B51
    One read-only audit run per area (SPI, CAN/MKS, time, gate, parameters,
    Pi host, trail); findings become stories that re-cut the code-alignment
    packages toward bench readiness.
2026-10-08 Replace workspace copies with overlays and point portal.toml at library
    Added icm-project/workspaces/implement-step.overlay/ and
    pre-merge-review.overlay/, each holding only what Karetao adds: the
    shared/references.md routing file and one References row in the workspace
    CONTEXT.md and in the two stage Inputs tables that use it. Removed the
    two whole-workspace copies, whose other text was stale library text.
    portal.toml now names the library workspaces plus the overlay folders,
    and the README describes overlays. CLAUDE.md mentions no copies, so is
    unchanged.
2026-10-14 Add MKS homing, PID and firmware-history reference notes
    Three notes from the MKS SERVO42D/57D CAN manual V1.0.9, checked against
    the PDF: homing and limit switches (90H-9EH, worked examples, Part 8), PID
    and miscellaneous configuration (96H, 97H, 87H, 8FH), and firmware
    history, precautions, error messages and schematic links. config-commands
    gains the per-mode speed, current and holding-current facts. CONTEXT.md
    lists the notes, the manual's contradictions and a comparison with the
    MksServo library.
2026-10-14 Add bench wiring schematic, bring-up checklist and joint sheet
    A connector-level KiCad schematic of the bench, generated by
    generate_schematic.py with a connectivity check (KiCad ERC: 0 violations).
    It covers the STM32 hub, TCA9548A and AS5600 encoders, the TJA1050 CAN
    transceiver, the Pi SPI header, the motor supply through the rocker switch
    and E-stop, and each MKS drive with its motor and home or limit switches.
    Switch wiring and motor phase order follow the original Arctos drawing and
    are Provisional until confirmed on the bench.
    BRING_UP.md is the phased bring-up checklist, including the SR_CLOSE
    holding check and the MKS heartbeat and synchronisation checks.
    JOINT_SHEET.md records the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
2026-10-14 Record drive commissioning facts and motor-control decisions
    Commissioning facts from Lenton Neale (2026-10-15):
    - Axis 0's encoder is not fitted; app_init.c and SYSTEM_CONFIGURATION
    section 2.1 now agree (axis 0 reports NOT_FITTED).
    - Motor 0 is a SERVO57D (CAN_SERVICE_MKS_SERVO57, 5200 mA limit).
    - Axes 4 and 5 are named Wrist Joint 2 and 3 (Arctos V2 convention);
    they remain the differential motors, SD-26 deferred.
    - New section 2.2: gear ratios, transmissions, switches, motors, drive
    models and CAN IDs 0x001 to 0x006.
    Decision log: MKS drive work mode SR_CLOSE (Provisional, holding check),
    MKS multi-motor synchronisation (in development), and the MKS motion
    commands from rulings R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
2026-10-14 Credit the Arctos V2 arm design and the MksServo origin
    The README now states that the arm is the Arctos V2 by Arctos Robotics
    (arctosrobotics.com), which Lenton built but did not design, and which
    parts of Karetao are his own work. The bench wiring README credits the
    Arctos V2 wiring as the source of the drive, motor and switch wiring.
    The MksServo README names its origin: Lenton's own earlier Python
    implementation, not in this repository.
2026-10-14 Explain the project's purpose and plan the carrier PCB for later
    The README gains a "Why Karetao" section: the motivation (an interest in
    robotics, and the Arctos arm as an affordable platform for developing
    embedded software and electronics design skills), the engineering aim
    and the first milestone.
    A custom carrier PCB for the STM32F405 and a Raspberry Pi Compute
    Module 5 is recorded as later work: a charter non-goal until the
    prototype bench hardware is tested and signed off, and listed under
    "Future, not now" in the system overview. doc_check allows "ROS 2" in
    the README's "Why Karetao" section, where it is named as later work.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
2026-10-14 Import the code-completion plan and record the review rulings
    The 2026-10-14 full code review's plan becomes work packages WP9 to WP16,
    with the rulings' consequences applied, plus WP17 (requirements amendment:
    hold on link loss) and WP18 (calibration, after the bench). Its stories
    are B52 to B127. WP8's audits are done and WP8 is closed; WP2 is reopened
    at Verification per ruling R29(b).
    The decision log gains a table of rulings R1 to R29, each mapped to the
    story that implements it. None is applied to the code yet.
2026-10-15 Take the firmware identity at build time, not configure time (B52)
    The git hash, commit time and dirty bit in VERSION frames were read
    by execute_process at configure time. After an edit, `cmake --build`
    without reconfiguring reported the old hash with dirty=0, so a bench
    record could cite a clean build that was not (SPI-19, FW-3, VER-39).
    cmake/firmware_identity.cmake now writes build/<preset>/generated/
    firmware_identity.h on every firmware build, through an always-run
    target. file(CONFIGURE) rewrites it only when the content changes, so
    an unchanged tree recompiles nothing. Details:
    - the hash is cut to exactly eight digits, so it always fits the field;
    - the dirty check covers Arm_Senso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
2026-10-15 Size the task stacks from the call graph and check them every build (B53)
    The default task had a 512-byte stack. Its deepest call path, an AS5600
    read through the mux and the HAL busy-wait, needs 524 bytes at -O0
    before an exception pushes anything, and overflow checking was off
    (FW-2). The snapshot serializer's 348-byte local payload would have
    added to that once snapshots are staged (PRM-9).
    - The snapshot payload is a file-scope buffer, claimed with an
    atomic_flag so a second caller gets no frame, not a mixed one.
    - Through the .ioc, regenerated with CubeMX 6.18.1: the defaultTask
    stack is 512 words, configCHECK_FOR_STACK_OVERFLOW 2 and
    INCLUDE_xTaskGetHandle 1.
    - tools/stack_depth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
2026-10-15 Fix review findings in the identity, stack and staging code
    From the review of B52 to B54:
    - Snapshot staging: one guard now covers every stage-and-publish in the
    SPI service, so the frame pool is protected as well as the snapshot
    payload buffer. A caller that arrives while another is staging gets
    the new SNAPSHOT_BUILD_BUSY result, never an interleaved frame.
    B53's payload-only flag is removed.
    - Firmware identity: when git cannot read the tree (for example
    "dubious ownership" in a CI container), the warning names git's
    error and the safe.directory remedy, instead of reporting a dirty
    tree. The identity stays conservative: hash 0, dirty set.
    - stack_depth.py: a caller named in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
2026-10-15 Record bench facts and the MKS drive settings decision
    Facts from Lenton Neale, 2026-10-15:
    - The AS5600s run on 5 V. The schematic generator now draws them on
    +5V and notes what is still Provisional and measured in BRING_UP
    phase 2 (B3): the mux supply, the upstream pull-ups, and the rail of
    the channel pull-ups on the breakouts. In 5 V mode a channel must
    reach about 0.7 x VDD.
    - The earlier firmware that moved joints X, Y and Z used the MKS
    factory-default CAN rate (ruling R9c), now in the matrix rows.
    - The drive settings he reported, in SYSTEM_CONFIGURATION section 2.2.
    - B74 records that PRM-ACQ-02 was measured on a Debug build.
    Datasheet citation: PB6, PB7, PB8 and PB9 are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
2026-10-15 Add a firmware architecture map for the Arm Sensor Hub
    Arm_Sensor_Hub/Documentation/README.md said the folder owns the service
    architecture, task structure and DMA and interrupt strategy, but no
    document described them. FIRMWARE_ARCHITECTURE.md is that map, as built
    on 2026-10-15:
    - the module map and who calls whom;
    - the single-task execution model and what runs in interrupt context;
    - the peripheral, pin and DMA allocation;
    - the interrupt priority rule and the stack-overflow stop;
    - the data flow from the sensors and CAN to the SPI frame;
    - lifecycle gating, and where the heap and each stack live;
    - where each configuration value comes from, including the headless
    CubeMX regeneration.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
2026-10-15 Define the system vocabulary and align the synchronization document with SYS-GATE-001
    SYSTEM_OVERVIEW.md gains a Vocabulary section, decided with Lenton Neale
    on 2026-10-15, in four tables: the arm's parts (joint, axis, motor,
    drive, joint encoder), the data path (sample, feedback, latest value,
    record, snapshot, message, SPI frame, transaction, transfer, exchange,
    publish, DATA_READY), time (TIME_SYNC as the as-built mechanism, clock
    sync as the target design, ClockSync as the Pi model, observation,
    offset and frequency, acquisition and synchronized timestamps, spread
    versus sync skew, link_stale), and gating (motion gate, fault, FAULT,
    ERROR and error, health versus response level, retry,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
2026-10-15 Plan the architecture deepening as stories B128 to B133 and amend their neighbours
    An architecture walk of Arm_Sensor_Hub/App and RaspberryPi_Sensor_Hub/
    src/spi on 2026-10-15 found eight deepening candidates. Seven were
    designed with Lenton Neale through question rounds the same day and
    are recorded here for the Portal to brief and build; no code changes.
    New stories, each with the settled interface, owners, tests and
    dependencies in its acceptance:
    - B128 S10.15 (WP10) latest-value store: samples and feedback in,
    ageing against freshness windows, one coherent snapshot copy out.
    - B129 S14.12 (WP14) system lifecycle module: motion lifecycle,
    global inhibit latch, dependency-ordered ac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
2026-10-15 Align the open issues with the 2026-10-15 rulings and retire the board's extra fields
    Review of the 13 open and 29 closed-today issues against main as of efe31e5.
    Every open body except #65 restated a decision changed by the R1 to R29 rulings
    or by the day's commits; the rewrites are drafted as gh commands in
    icm-project/workspaces/issue-alignment-2026-10-15/ and not yet run.
    Rulings taken during the review (Lenton Neale, 2026-10-15):
    - R16 corrected to T2, the STM32 receipt instant; TIME_SYSTEM_INTERFACE defines T4 as the Pi receipt.
    - PRM-TS-06: ClockSync plausibility rejection, Provisional, confirmed from the Gate A data.
    - MKS drive settings: the firmware checks and withholds motor_read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
2026-10-15 Retire the ICM Portal and track work as issues, milestones, dependencies and the board
    Decisions by Lenton Neale, 2026-10-15 evening. The Portal and its work-package Map
    (icm-project/lifecycle.json, backlog.json) stop being the plan; both files stay in git
    history (247cf35) and their stories migrate into GitHub issues stage by stage.
    - Above the issue level: native Milestones (Stage 0 Foundation, Stages 1 to 5), GitHub
    native issue dependencies for blocking, and the Karetao Engineering Project board for
    Status and manual order. Blocked, Ready and Backlog are derived from the dependency
    graph and the current stage by icm-project/tools/issue_graph, which also sets the order.
    - Skills: .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
2026-10-15 Record the Stage 0 and 1 migration and add the tool-owned Blocking field to the board
    The migration script ran on 2026-10-15 (interrupted once after the milestone and 11
    issues; gh-commands-resume.sh finished it): milestone "Stage 0 — Foundation", issues
    #68 to #93, the dependency edges, and the origin line on #66. MAPPING.md records which
    story became which issue.
    create-views.sh added the Now, By stage and Chokepoints views. GitHub exposes no
    dependency counts to views, so the board gets a Number field "Blocking" that
    issue_graph --apply writes from the graph; the card and the issue contract say so.
    GraphQL numbers are passed with -F, not -f.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
2026-10-15 Add shared SPI golden frames asserted by the C and Python suites (#68)
    shared/test-vectors/spi/frames.txt holds 13 as-built transactions, written by
    make_vectors.py from plain struct and zlib. The host test spi_golden_vector_tests
    puts spi_protocol.c in each vector's state and compares all 512 response bytes
    and the state that follows; test_golden_vectors.py encodes each request, decodes
    each response, checks NACK status names and correlation, and checks the file
    against its generator. This is the evidence for the SYS-SPI-001 acceptance
    clause "the C and Python protocol tests exchange the same frames bit-for-bit".
    Contract constants have one home per side: SPI_FRAME_MAGIC, the ACK/NACK layo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
2026-10-15 Add the run-record module and the evidence-record tool with firmware and Pi identity (#70)
    run_record.py defines the run directory (meta.json plus one CSV per series)
    that capture tools write and the PC side reads: run kind, rig, the IDs the
    run informs, local start time with its UTC offset, the capture command, the
    firmware identity decoded from VERSION, and the Pi commit with a dirty flag
    scoped to RaspberryPi_Sensor_Hub/ and shared/, the mirror of the firmware's
    build-time check. A git failure is recorded as unknown and dirty.
    evidence_record.py drafts the record from meta.json: every tool-readable
    required field, attachments by relative path, and whether the run may
    satisfy a matrix row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
2026-10-16 Remove the dead async I2C path and duplicated firmware code (#77)
    Resolves review findings FW-14 and FW-29 as a delete-only diff before the
    Stage 1 rewrite of i2c_manager (#80).
    - i2c_manager: drop SubmitAsync, the HAL completion callbacks that gave the
    mutex from an ISR (a FreeRTOS mutex held by a task cannot be given from an
    interrupt; xQueueGiveFromISR asserts), the ISR dispatch queue, the event
    hook, queue and notify setters, the deferred fault handoff and
    I2CManager_Process, MasterRead, GetHandle and the newly dead MasterWrite.
    - Core: remove the I2C1 NVIC enable and the two IRQ handlers from their
    USER CODE blocks and the I2CManager_Process call from the main loop. A
    headl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
2026-10-16 Write the working rhythm into /work-issue and /next-issue (#99)
    One issue in flight at a time, merged to main before the next starts:
    an issue closes only when its PR merges, and issue_graph counts
    blockers and the current stage by open issues only. /work-issue now
    checks blockers before setting Status, resumes work in flight, creates
    its worktree by absolute path from origin/main, merges on Lenton's word
    once CI passes, and closes out (branches, worktree, Done, board).
    /next-issue reports work in flight before recommending. The note
    template gains a decision-issue variant.
2026-10-16 Add the latest-value store that owns ageing and the coherent snapshot copy (#80)
    One module, latest_value.[ch], replaces sensor_latest_value and
    motor_latest_value. Producers only accept: the sensor task a classified
    sample, the CAN service typed 30H position and 32H speed feedback merged
    with per-field timestamps. The SPI service copies the store under a FreeRTOS
    critical section into a static buffer and SpiProtocol_SerializeSnapshot
    (spi_protocol.c) serialises the copy, so no record changes during
    serialisation or DMA (SPI_SYSTEM_INTERFACE.md section 8, ruling R15).
    Freshness is judged at copy time from the caller's now: PRM-ACQ-07 (new,
    5 x PRM-ACQ-05) for sensors, PRM-MOT-01 for motors.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
2026-10-16 Make the dependency graph the board order and rank by issues downstream (#97)
    The board order is computed by issue_graph from native edges and never set
    by hand, since --apply re-places every open issue after each merge. The
    tie-break within a stage counts every open issue downstream instead of
    direct dependents only, so the head of the longest chain leads. The open
    issue listing is paged. Contract, framework, tool card and /next-issue
    follow; no-milestone issues (bench) sort last and are picked by hand.
2026-10-16 Write the stage-gate and membership rule into the issue contract (#101)
    The contract's Milestones section now states the rule decided in #95 and
    #98: a stage is a gate; the current stage is the lowest Stage N by the
    milestone title, not GitHub's milestone number; an issue sits in the lower
    of the stage it delivers and the lowest stage holding an issue it blocks;
    no milestone is reserved for planning tickets and bench bring-up, the one
    exception to membership by edge. The Order paragraph and the issue_graph
    card point to it. Research note in icm-project/research/101-stage-gate-contract.md.
2026-10-16 Remove data_ready_analysis.py and the dead DATA_READY record fields (#93)
    Ruling R7 (findings HOST-20, VER-19, PRM-15): the module graded three
    TransactionRecord fields that nothing sets against a 5 ms bound from
    retired SYS-SPI-004 with no register row. Delete the module, its 17
    tests, the three fields and data_ready_latency_ms(). Drop the deleted
    test from the SYS-SPI-001 matrix row and correct the harness README:
    DATA_READY-to-NSS timing is a Stage 3 logic-analyser measurement.
2026-10-16 Add the Pi ExchangeSession, a firmware-rules fake and a process-wide Sequencer (#78)
    exchange.py holds ExchangeSession, grown from TimingSession: transact()
    clocks and correlates one transaction; exchange() clocks the request
    then a filler until its reply or NACK correlates or the budget is spent,
    returning replied, refused or exhausted without raising. A correlated
    record carries T1 and T4 (and T2 once its wire placement is fixed), so
    ClockSync's owner feeds it from the records; the session does not
    depend on ClockSync.
    spi_protocol.py gains the process-wide Sequencer (R3; the bounded jump
    is #87's) and the ACK/NACK and VERSION encoders. fake_backend.py is one
    SpiBackend enforcing the firm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
2026-10-16 Move the Pi tools onto ExchangeSession and delete SpiDevice and the five fakes (#102)
    The timing harness, the link probe and the time-sync probe now clock the
    link only through ExchangeSession, and each runs against FakeFirmware with
    --fake. The time-sync probe matched a reply in the request's own
    transaction, which a pipelined slave never satisfies; it now correlates by
    request_seq through exchange(), stamps pi_time_us on the session's raw clock
    after the pacing gap, and drops a sample whose seq another caller took.
    spi_device.py (SpiDevice) and timing.py (TimingSession) are deleted; the
    statistics helpers move into the harness, their only caller. The five test
    fakes and the harness's own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
2026-11-02 Simplify the exchange session's callers after #78/#102
    - exchange.py owns the GET requests (GET_VERSION, GET_SNAPSHOT, GET_REQUESTS)
    and MIN_EXCHANGE_BUDGET; the tools import them instead of rebuilding them.
    - ExchangeResult.refusal_reason() gives the NACK reason plus remedy once, for
    both the link probe's verdict and the harness's read_version.
    - Callers pass min_interval_s unconditionally: _pace already ignores it when
    DATA_READY is configured.
    - The harness builds its block and identity sessions through one helper.
    - _transact passes timing values straight to _record instead of building a
    kwargs dict inside the measured decode window.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
